alphaonex86/FPGA-ONU-1GPON-1GE/common/sniffer/sniffer-GPON-v2.jpg

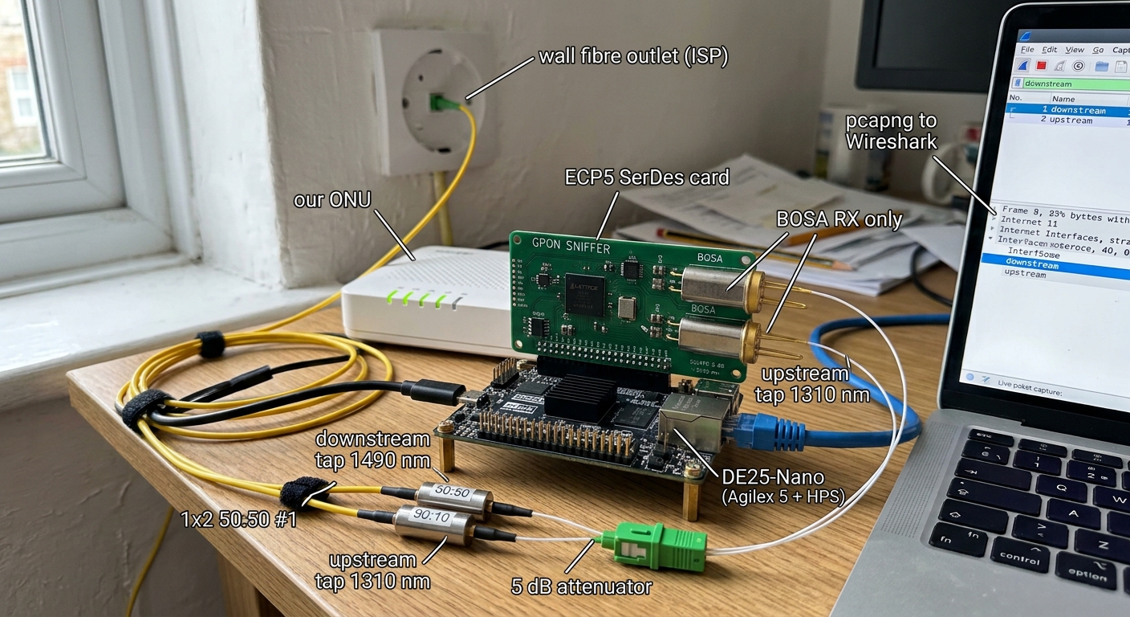
common/sniffer/sniffer-GPON-v2.jpg
