alphaonex86/FPGA-ONU-1GPON-1GE/common/sniffer/sniffer-GPON.jpg

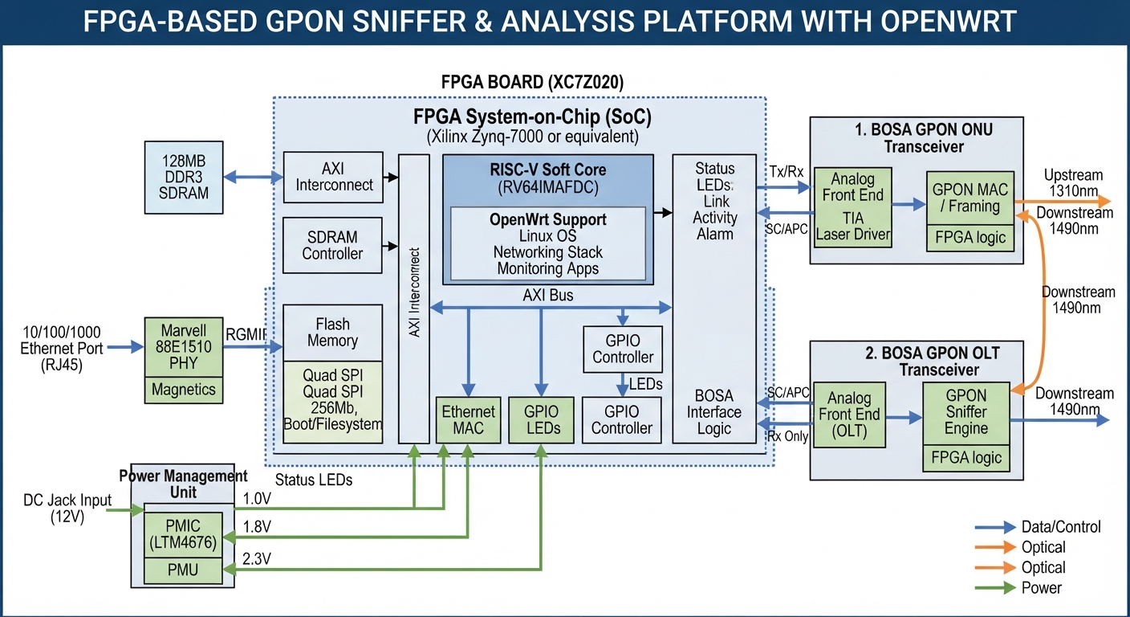
common/sniffer/sniffer-GPON.jpg
