alphaonex86/FPGA-ONU-1GPON-1GE/common/sniffer/sniffer-diagram.png

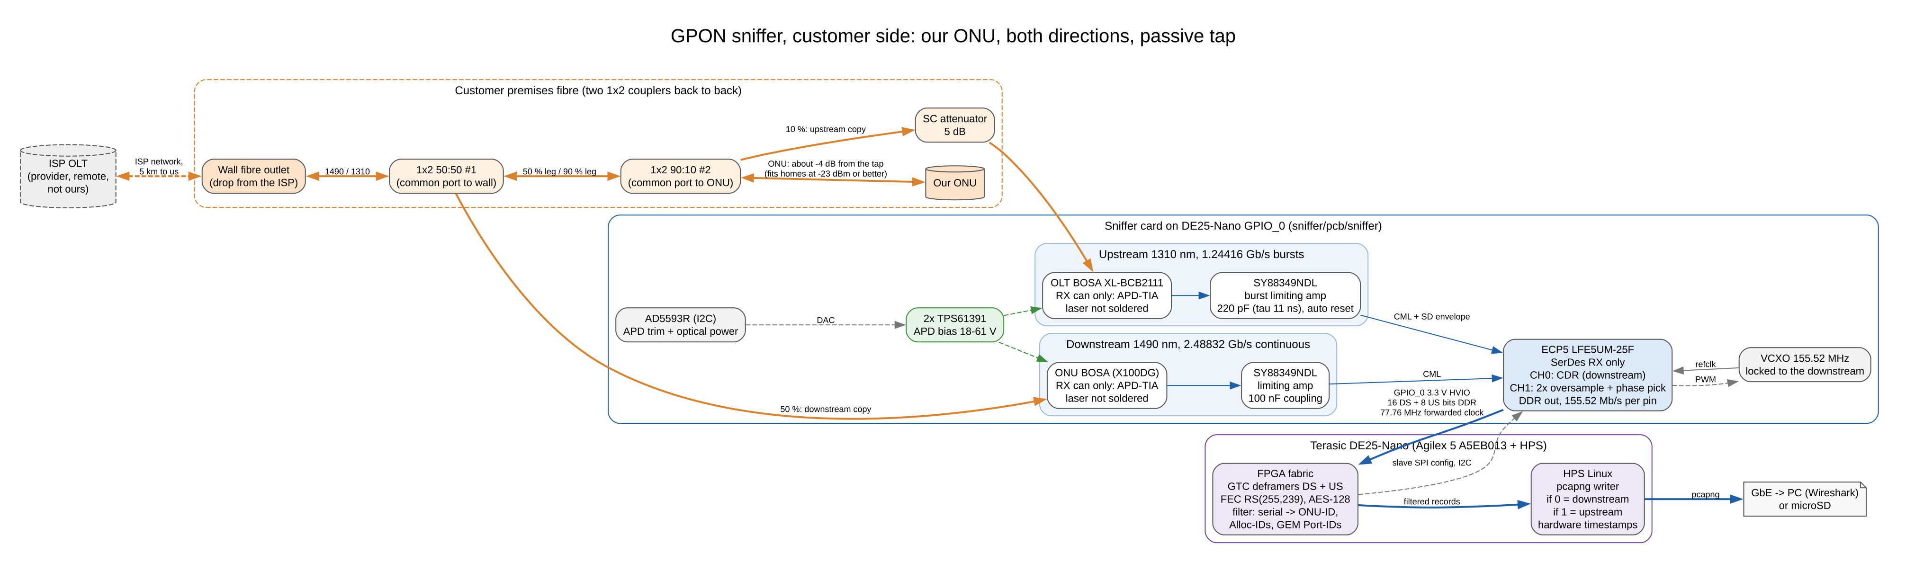
common/sniffer/sniffer-diagram.png
