alphaonex86/FPGA-ONU-1GPON-1GE/de25-standard/fpga-usage/README.md

# FPGA usage

Written by `agilex5/gts/usage_svg.py` at the end of every `fit.sh` PonBoard or ghrd fit: do not edit.

## ghrd

ghrd resources

ghrd blocks

ghrd onu

ghrd olt

## pon_board

pon_board resources

pon_board blocks

pon_board onu

pon_board olt
