alphaonex86/FPGA-ONU-1GPON-1GE/de25-standard/pcb/hsmc/sim/laser_driver.cir

* SPDX-License-Identifier: CERN-OHL-S-2.0
* BFR380F model: rough Gummel-Poon fit of the public datasheet (hFE 120, fT 14 GHz, Ccb 0.5 pF), not the vendor model
* Discrete burst-mode laser driver, 5 V laser rail, BFR380F current steering
.param ibias=30m imod=30m ui=803.75p
.model bfr NPN(IS=2e-15 BF=120 NF=1 VAF=30 IKF=0.15 RB=4 RE=0.4 RC=2 CJE=1.2p VJE=0.8 MJE=0.4 CJC=0.5p VJC=0.6 MJC=0.35 TF=9p TR=1n XTF=2 ITF=0.1)
.subckt q c b e
Lb b bi 0.4n
Le e ei 0.3n
Lc c ci 0.4n
Q1 ci bi ei bfr
.ends
.model las D(IS=1e-18 N=2 RS=4 CJO=2p)
V5 v5 0 5
V33 v33 0 3.3
* BOSA: laser anode on +5V_LD through the lead, cathode lead to the driver
Lla v5 la 2n
Dl la lk las
Llk lk ldk 2n
Rsn ldk sn 22
Csn sn v5 22p
* modulation pair, data AC-coupled from the GTS lane (+-200 mV per side), bases biased at 2.3 V through the 50 ohm terminations
Vd dp0 0 PWL(
+ 0.000000e+00 -1 4.822531e-09 -1 4.847531e-09 1 5.626286e-09 1 5.651286e-09 -1 9.645062e-09 -1
+ 9.670062e-09 1 1.125257e-08 1 1.127757e-08 -1 1.446759e-08 -1 1.449259e-08 1 1.527135e-08 1
+ 1.529635e-08 -1 1.607510e-08 -1 1.610010e-08 1 1.687886e-08 1 1.690386e-08 -1 1.929012e-08 -1
+ 1.931512e-08 1 2.250514e-08 1 2.253014e-08 -1 2.411265e-08 -1 2.413765e-08 1 2.491641e-08 1
+ 2.494141e-08 -1 2.732767e-08 -1 2.735267e-08 1 2.813143e-08 1 2.815643e-08 -1 2.893519e-08 -1
+ 2.896019e-08 1 3.054270e-08 1 3.056770e-08 -1 3.215021e-08 -1 3.217521e-08 1 3.456147e-08 1
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
print lon loff
meas tran vce_min_m1 min v(ldk)
meas tran vme max v(me)
meas tran vmt min v(mt)
meas tran vbt min v(bt)
meas tran ilmax max i(Lla) from=100n to=1.1u
meas tran ilmin min i(Lla) from=100n to=1.1u
wrdata laser.txt i(Lla) v(ben) v(bc) v(me) v(ldk) v(la) v(lk) v(mt) v(bt)
.endc
.end
