alphaonex86/FPGA-ONU-1GPON-1GE/de25-standard/pcb/hsmc/hsmc.kicad_pcb

## KiCad design de25-standard/pcb/hsmc/hsmc.kicad_pcb (2026-11-05)

Schematic: hsmc.kicad_sch, HSMC card for DE25-Standard: OLT/Ethernet and Ethernet SFP+…

Parts:
C1, C2, C7, C8, C11, C12, C15, C16, C18, C25, C27, C30, C32, C35, C36, C37, C38, C39, C40, C41, C42, C45, C46, C47, C48, C49, C51, C60, C61, C63, C65, C66: 100n; C_0402_1005Metric
C3, C4, C17, C26, C28, C31, C33, C43, C44, C50, C52: 10u; C_0603_1608Metric
C5, C6, C22, C23, C24, C29, C34: 22u; C_0805_2012Metric
C9, C10, C13, C14: 1u; C_0402_1005Metric
C19, C20: 10u; C_0805_2012Metric; MPN 10 uF 25 V X5R 0805
C21: 100n; C_0603_1608Metric; MPN 100 nF 25 V
C53, C54: 100n; C_0603_1608Metric; MPN 100 V X7R
C55: 220p; C_0603_1608Metric; MPN 100 V X7R
C56: 47n; C_0402_1005Metric
C57: 2.2u; C_0603_1608Metric
C58, C59: 10p; C_0402_1005Metric
C62: 100n; C_0603_1608Metric; MPN 100 nF 50 V X7R 0603
C64: 47p; C_0402_1005Metric
D1: BAT46WJ; D_SOD-323F; MPN BAT46WJ (100 V)
FB1, FB2, FB3, FB4: 120R@100MHz; L_0603_1608Metric; MPN BLM18PG121SN1D
H1, H2: M3; MountingHole_3.2mm_M3
J1: ASP-122952-01; HSMC_ASP-122952-01; MPN Samtec ASP-122952-01
J2: SFP0 cage; Connector_SFP_and_Cage; MPN SFP+ cage (SFF-8432) + 20-pin host conn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
J3: SFP1 cage; Connector_SFP_and_Cage; MPN SFP+ cage (SFF-8432) + 20-pin host conn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
L1: 2.2u; L_Cenker_CKCS4020; MPN 2.2 uH, Isat >= 4 A, 4020
L2, L3, L4, L5: 1u; L_0805_2012Metric; MPN 1 uH >= 1 A, low DCR
L6: 4.7u; L_Cenker_CKCS252012; MPN 4.7 uH, Isat >= 1 A, 2520
R1, R2, R5, R6: 150; R_0402_1005Metric
R3, R4, R7, R8, R10, R32, R34, R45, R51: 10k; R_0402_1005Metric
R9: 33.2k; R_0402_1005Metric
R11, R19: 33; R_0402_1005Metric
R12, R20: 330; R_0402_1005Metric
R13, R14, R15, R16, R17, R18, R21, R22, R23, R24, R25, R26, R27, R28, R52, R53, R57: 4.7k; R_0402_1005Metric
R29: 5.1k; R_0402_1005Metric
R30: 6.2k; R_0402_1005Metric
R31, R46: 20k; R_0402_1005Metric
R33: 12k; R_0402_1005Metric
R35: 5.6k; R_0402_1005Metric
R36: 3.9k; R_0402_1005Metric
R37, R49: 1.5k; R_0402_1005Metric
R38, R43, R56: 1k; R_0402_1005Metric
R39, R41, R48: 10; R_0402_1005Metric
R40: 15; R_0402_1005Metric
R42: 100; R_0402_1005Metric
R44: 300k; R_0603_1608Metric
R47: 33k; R_0402_1005Metric
R50: 3.01k; R_0402_1005Metric
R54: 0; R_0402_1005Metric; not fitted
R55: 15k; R_0402_1005Metric
R58, R59, R60, R61: 20; R_0402_1005Metric
U1: TPS563201DDCR; SOT-23-6; MPN TPS563201DDCR
U2: SY88236LMG; QFN-32-1EP_5x5mm_P0.5mm_EP3.1x3.1mm_ThermalVias; MPN SY88236LMG
U3: SN65LVDT2DBVR; SOT-23-5; MPN SN65LVDT2DBVR
U4: BOSA GPON (X100DG); BOSA_GPON; MPN desoldered from an X100DG; pad order to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
U5: TPS61391RTER; WQFN-16-1EP_3x3mm_P0.5mm_EP1.68x1.68mm_ThermalVias; MPN TPS61391RTER
U6: AD5593RBRUZ; TSSOP-16_4.4x5mm_P0.65mm; MPN AD5593RBRUZ
U7: SN74LVC1G123DCUR; VSSOP-8_2.3x2mm_P0.5mm; MPN SN74LVC1G123DCUR
U8: SN74LVC1G97DBVR; SOT-23-6; MPN SN74LVC1G97DBVR
U9: SN74LVC1G32DBVR; SOT-23-5; MPN SN74LVC1G32DBVR
Y1: SiT3821 156.25 MHz; Oscillator_SMD_SiTime_SiT9121-6Pin_3.2x2.5mm; MPN SiT3821AI-1B2-33NH156.250000
Y2: SiT3821 155.52 MHz; Oscillator_SMD_SiTime_SiT9121-6Pin_3.2x2.5mm; MPN SiT3821AI-1B2-33NE155.520000

Connections:
+3V3: C1.1, C2.1, C3.1, C4.1, C5.1, C6.1, C61.1, C63.1, C65.1, C66.1, FB1.1, FB2.1, FB4.1, J1.45 (3.3V), J1.51 (3.3V), J1.57 (3.3V), J1.63 (3.3V), J1.69 (3.3V), J1.75 (3.3V), J1.81 (3.3V), J1.87 (3.3V), J1.93 (3.3V), J1.99 (3.3V), J1.105 (3.3V), J1.111 (3.3V), J1.117 (3.3V), J1.123 (3.3V), J1.129 (3.3V), J1.135 (3.3V), J1.141 (3.3V), J1.147 (3.3V), J1.153 (3.3V), J1.159 (3.3V), R27.2, R28.2, R51.2, R52.2, R53.2, R55.2, R57.2, U6.3 (V_{DD}), U6.9 (V_{LOGIC}), U7.3 (~CLR), U7.8 (VCC), U8.5 (VCC), U9.5 (VCC)
+3V3_APD: C51.1, C52.1, FB4.2, L6.1, R48.1, U5.10 (VIN), U5.13 (EN)
+3V3_APDA: C57.1, R48.2, U5.14 (AVCC), U5.15 (AVCC)
+3V3_OPT: C39.1, C40.1, C41.1, C42.1, C43.1, C44.1, C45.1, FB2.2, FB3.1, R29.2, R40.2, U2.17 (VCC), U2.20 (VCC), U2.32 (VCC), U3.1 (VCC), U4.T1 (LD_A), U4.T4 (MPD_K)
+3V3_RX: C48.1, C49.1, C50.1, FB3.2, U4.R2 (VCC)
+3V3_SFP: C22.1, C23.1, C24.1, C29.1, C34.1, L1.2, L2.1, L3.1, L4.1, L5.1, R9.1, R13.2, R14.2, R15.2, R16.2, R17.2, R18.2, R21.2, R22.2, R23.2, R24.2, R25.2, R26.2
+3V3_SFP0R: C27.1, C28.1, J2.15 (VccR), L3.2
+3V3_SFP0T: C25.1, C26.1, J2.16 (VccT), L2.2
+3V3_SFP1R: C32.1, C33.1, J3.15 (VccR), L5.2
+3V3_SFP1T: C30.1, C31.1, J3.16 (VccT), L4.2
+3V3_XO: C15.1, C16.1, C17.1, FB1.2, Y1.6 (VDD), Y2.6 (VDD)
+12V: C19.1, C20.1, C21.1, J1.88 (12V), J1.94 (12V), J1.100 (12V), U1.3 (VIN), U1.5 (EN)
APCFAULT_N: U2.25 (~APCFAULT), U6.13 (IO7)
APCSET: R31.1, R32.1, U2.12 (APCSET)
APC_ADJ: R32.2, U6.4 (IO0)
APD_ADJ: R46.2, U6.6 (IO2)
APD_CAP: C56.1, U5.9 (CAP)
APD_FB: R44.2, R45.1, R46.1, U5.12 (FB)
APD_ISHORT: R47.1, U5.11 (ISHORT)
APD_MON: C58.1, R49.1, U5.4 (MON1), U6.11 (IO5)
APD_MON2: C59.1, R50.1, U5.3 (MON2)
BEN_DLY: C64.1, R56.2, U8.1 (IN1)
BEN_IO: J1.120 (LVDS_RXp11), R54.1
BIASMAX: R35.1, U2.14 (BIASMAX)
BIASMON: R37.1, U2.23 (BIASMON), U6.7 (IO3)
BST_SFP: C18.1, U1.6 (VBST)
BURST_CUT: J1.116 (LVDS_RXn10), U8.4 (Y), U9.2
CUT_C: C62.1, U7.6 (Cext)
CUT_Q: U7.5 (Q), U8.6 (IN2)
CUT_RC: C62.2, R55.1, U7.7 (RCext)
DDM_RESET: R51.1, U6.1 (~RESET)
DDM_VREF: C60.1, U6.8 (V_{REF})
FB_SFP: R9.2, R10.1, U1.4 (VFB)
GND: C1.2, C2.2, C3.2, C4.2, C5.2, C6.2, C9.2, C10.2, C13.2, C14.2, C15.2, C16.2, C17.2, C19.2, C20.2, C21.2, C22.2, C23.2, C24.2, C25.2, C26.2, C27.2, C28.2, C29.2, C30.2, C31.2, C32.2, C33.2, C34.2, C39.2, C40.2, C41.2, C42.2, C43.2, C44.2, C45.2, C48.2, C49.2, C50.2, C51.2, C52.2, C53.2, C54.2, C55.2, C56.2, C57.2, C58.2, C59.2, C60.2, C61.2, C63.2, C64.2, C65.2, C66.2, J1.160 (PSNTn), J1.161 (GND), J1.162 (GND), J1.163 (GND), J1.164 (GND), J1.165 (GND), J1.166 (GND), J1.167 (GND), J1.168 (GND), J1.169 (GND), J1.170 (GND), J1.171 (GND), J1.172 (GND), J2.1 (VeeT), J2.10 (VeeR), J2.11 (VeeR), J2.14 (VeeR), J2.17 (VeeT), J2.20 (VeeT), J2.CAGE, J3.1 (VeeT), J3.10 (VeeR), J3.11 (VeeR), J3.14 (VeeR), J3.17 (VeeT), J3.20 (VeeT), J3.CAGE, R1.2, R2.2, R5.2, R6.2, R10.2, R30.2, R31.2, R33.2, R35.2, R36.2, R37.2, R38.2, R45.2, R47.2, R49.2, R50.2, U1.1 (GND), U2.1 (LOS/SD_SEL), U2.5 (GND), U2.8 (GND), U2.16 (GND), U2.24 (GND), U2.29 (GND), U2.33 (EP), U3.2 (GND), U4.R5 (GND), U5.7 (GND), U5.16 (AGND), U5.17 (EP), U6.2 (A0), U6.14 (GND), U7.1 (~A), U7.4 (GND), U8.2 (GND), U8.3 (IN0), U9.3 (GND), Y1.3 (GND), Y2.3 (GND)
GTS_REFCLK_AC_N: C8.2, R59.1
GTS_REFCLK_AC_P: C7.2, R58.1
GTS_REFCLK_N: J1.8 (XCVR_RXn6), R59.2
GTS_REFCLK_P: J1.6 (XCVR_RXp6), R58.2
GTS_RXREF_AC_N: C12.2, R61.1
GTS_RXREF_AC_P: C11.2, R60.1
GTS_RXREF_N: J1.4 (XCVR_RXn7), R61.2
GTS_RXREF_P: J1.2 (XCVR_RXp7), R60.2
HV_APD: C55.1, U4.R1 (VAPD), U5.5 (APD)
HV_FILT: C54.1, R42.2, R43.1
HV_MONIN: R43.2, U5.6 (MONIN)
HV_OUT: C53.1, D1.1 (K), R42.1, R44.1
HV_SW: D1.2 (A), L6.2, U5.8 (SW)
LASER_DIS: R27.1, U2.11 (TXDIS), U9.4
LASER_DIS_FPGA: J1.102 (LVDS_RXp8), R57.1, U9.1
LD_BEN: R54.2, R56.1, U2.9 (BEN+), U3.5 (R), U7.2 (B)
LD_BEN_N: R30.1, U2.10 (BEN-)
LD_BIAS: R41.1, U2.21 (BIAS)
LD_K: R39.2, R41.2, U4.T2 (LD_K)
LD_MD: U2.22 (MD), U4.T3 (MPD_A)
LD_MODN: R40.1, U2.18 (MOD-)
LD_MODP: R39.1, U2.19 (MOD+)
LOSLVL: R29.1, U2.2 (LOSLVL)
MODMON: R36.1, U2.15 (MODMON), U6.10 (IO4)
MODSET: R33.1, R34.1, U2.13 (MODSET)
MOD_ADJ: R34.2, U6.5 (IO1)
ONU_BEN_N: J1.31 (XCVR_TXn0), U3.4 (B)
ONU_BEN_P: J1.29 (XCVR_TXp0), U3.3 (A)
ONU_RD_N: C38.1, U2.30 (ROUT-)
ONU_RD_P: C37.1, U2.31 (ROUT+)
ONU_RX_N: C38.2, J1.26 (XCVR_RXp1)
ONU_RX_P: C37.2, J1.28 (XCVR_RXn1)
ONU_SCL: J1.108 (LVDS_RXp9), R52.1, U6.16 (SCL)
ONU_SDA: J1.110 (LVDS_RXn9), R53.1, U6.15 (SDA)
ONU_TD_N: C36.2, U2.6 (DIN+)
ONU_TD_P: C35.2, U2.7 (DIN-)
ONU_TX_N: C36.1, J1.25 (XCVR_TXp1)
ONU_TX_P: C35.1, J1.27 (XCVR_TXn1)
RIN_N: C47.2, U2.28 (RIN-)
RIN_P: C46.2, U2.27 (RIN+)
RSSI: R38.1, U2.26 (RSSI), U6.12 (IO6)
RX_SD: J1.104 (LVDS_RXn8), R28.1, U2.3 (LOS/SD), U2.4 (~JAM)
SFP0_LOS: J1.48 (LVDS_RXp0), J2.8 (RX_LOS), R15.1
SFP0_MOD_ABS: J1.50 (LVDS_RXn0), J2.6 (MOD_ABS), R16.1
SFP0_P7: J2.7 (RS0), R11.2
SFP0_P9: J2.9 (RS1), R12.2
SFP0_RD_N: J1.18 (XCVR_RXp3), J2.12 (RD-)
SFP0_RD_P: J1.20 (XCVR_RXn3), J2.13 (RD+)
SFP0_RS0: J1.60 (LVDS_RXp2), R11.1
SFP0_RS1: J1.62 (LVDS_RXn2), R12.1
SFP0_SCL: J1.54 (LVDS_RXp1), J2.5 (SCL), R17.1
SFP0_SDA: J1.56 (LVDS_RXn1), J2.4 (SDA), R18.1
SFP0_TD_N: J1.19 (XCVR_TXn3), J2.19 (TD-)
SFP0_TD_P: J1.17 (XCVR_TXp3), J2.18 (TD+)
SFP0_TX_DIS: J1.42 (D1), J2.3 (TX_DISABLE), R14.1
SFP0_TX_FAULT: J1.44 (D3), J2.2 (TX_FAULT), R13.1
SFP1_LOS: J1.72 (LVDS_RXp4), J3.8 (RX_LOS), R23.1
SFP1_MOD_ABS: J1.74 (LVDS_RXn4), J3.6 (MOD_ABS), R24.1
SFP1_P7: J3.7 (RS0), R19.2
SFP1_P9: J3.9 (RS1), R20.2
SFP1_RD_N: J1.22 (XCVR_RXp2), J3.12 (RD-)
SFP1_RD_P: J1.24 (XCVR_RXn2), J3.13 (RD+)
SFP1_RS0: J1.84 (LVDS_RXp6), R19.1
SFP1_RS1: J1.86 (LVDS_RXn6), R20.1
SFP1_SCL: J1.78 (LVDS_RXp5), J3.5 (SCL), R25.1
SFP1_SDA: J1.80 (LVDS_RXn5), J3.4 (SDA), R26.1
SFP1_TD_N: J1.23 (XCVR_TXn2), J3.19 (TD-)
SFP1_TD_P: J1.21 (XCVR_TXp2), J3.18 (TD+)
SFP1_TX_DIS: J1.66 (LVDS_RXp3), J3.3 (TX_DISABLE), R22.1
SFP1_TX_FAULT: J1.68 (LVDS_RXn3), J3.2 (TX_FAULT), R21.1
SW_SFP: C18.2, L1.1, U1.2 (SW)
TIA_N: C47.1, U4.R4 (OUT-)
TIA_P: C46.1, U4.R3 (OUT+)
VCXO156_N: C8.1, R2.1, Y1.5 (OUT-)
VCXO156_P: C7.1, R1.1, Y1.4 (OUT+)
VCXO156_PWM: J1.122 (LVDS_RXn11), R3.1
VCXO156_RC: C9.1, R3.2, R4.1
VCXO156_VC: C10.1, R4.2, Y1.1 (VIN)
VCXO_N: C12.1, R6.1, Y2.5 (OUT-)
VCXO_P: C11.1, R5.1, Y2.4 (OUT+)
VCXO_PWM: J1.114 (LVDS_RXp10), R7.1
VCXO_RC: C13.1, R7.2, R8.1
VCXO_VC: C14.1, R8.2, Y2.1 (VIN)

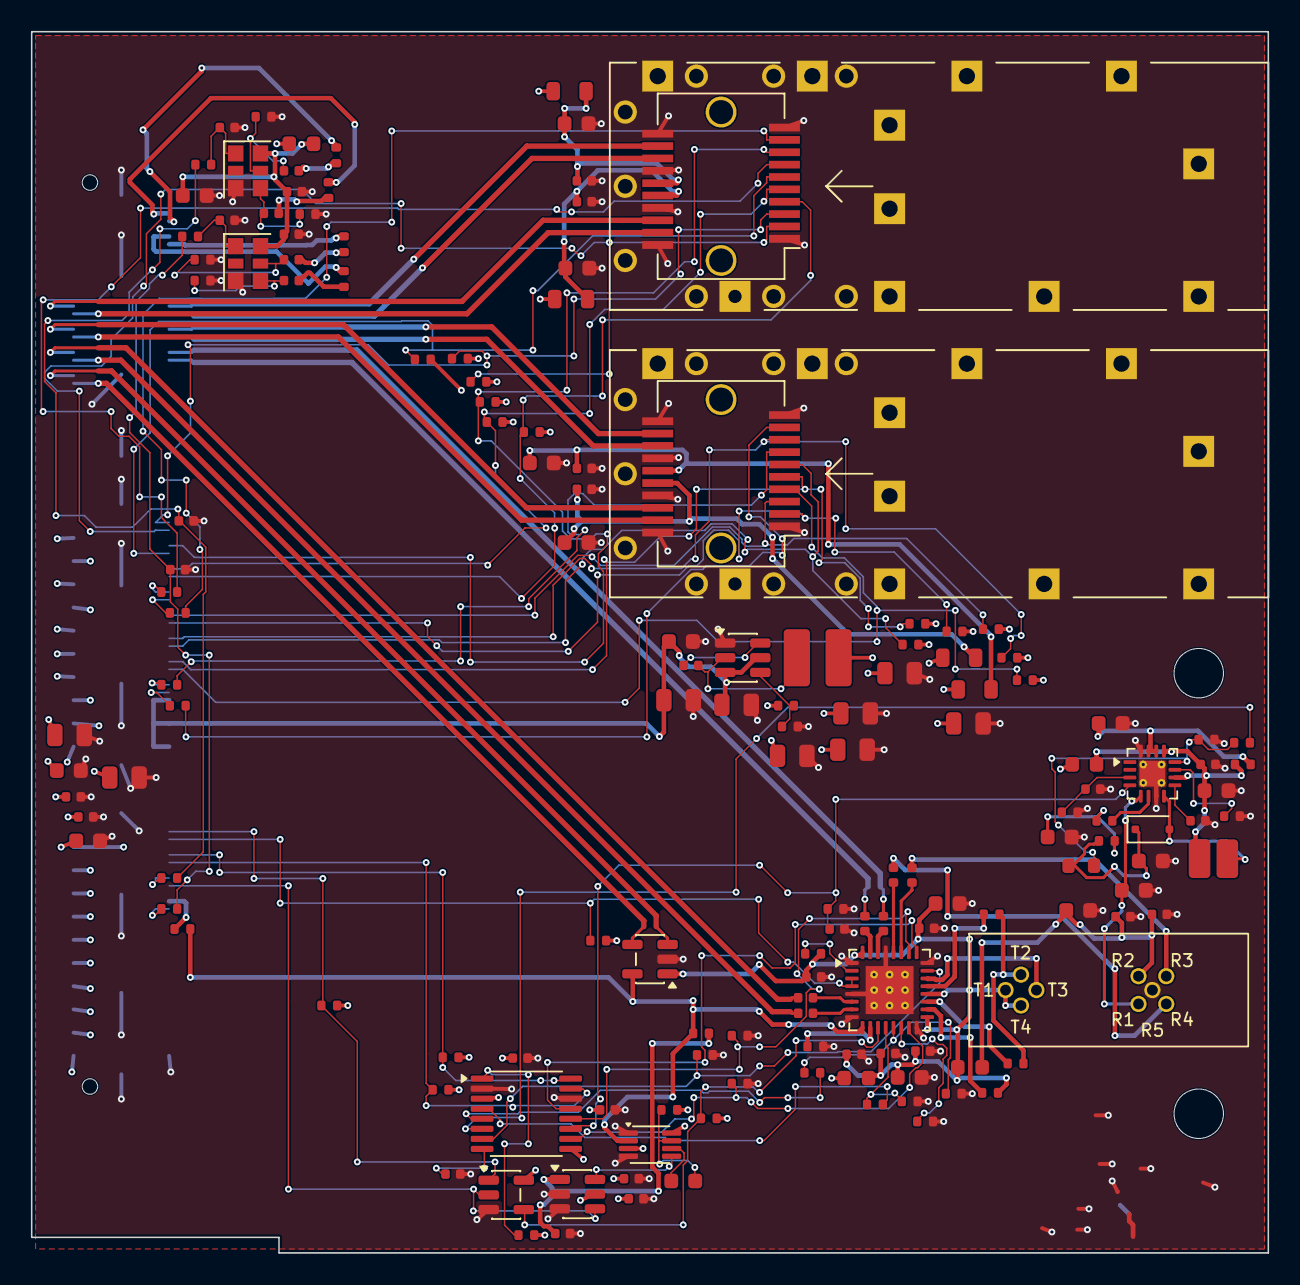
[picture p4: board hsmc.kicad_pcb from above]

Board: 4 copper layers, 80.0 x 79.0 mm, 154 parts (1 on the bottom side), 117 nets.
