alphaonex86/FPGA-ONU-1GPON-1GE/de25-nano/pcb/onu/onu.kicad_pcb

## KiCad design de25-nano/pcb/onu/onu.kicad_pcb (2026-11-05)

Schematic: onu.kicad_sch, ONU SerDes bridge for DE25-Nano

Parts:
C1, C3, C6, C9, C24, C25, C30, C48, C49, C50, C51, C54, C57, C60, C63, C65, C76, C77, C83, C85: 10u; C_0603_1608Metric
C2, C4, C5, C7, C8, C10, C11: 22u; C_0805_2012Metric
C12, C13, C66, C67: 1u; C_0402_1005Metric
C14, C15, C16, C17, C18, C19, C20, C21, C22, C23, C26, C27, C28, C29, C31, C32, C33, C34, C35, C36, C37, C38, C39, C40, C41, C42, C43, C44, C45, C46, C47, C52, C53, C55, C56, C58, C59, C61, C62, C64, C68, C69, C70, C71, C72, C73, C74, C75, C78, C79, C80, C81, C82, C84, C93, C94: 100n; C_0402_1005Metric
C86, C87: 100n; C_0603_1608Metric; MPN 100 V X7R
C88: 220p; C_0603_1608Metric; MPN 100 V X7R
C89: 47n; C_0402_1005Metric
C90: 2.2u; C_0603_1608Metric
C91, C92: 10p; C_0402_1005Metric
D1: BAT46WJ; D_SOD-323F; MPN BAT46WJ (100 V)
FB1, FB2, FB3, FB4, FB5, FB6, FB7, FB8, FB9: 120R@100MHz; L_0603_1608Metric; MPN BLM18PG121SN1D
H1, H2: M3; MountingHole_3.2mm_M3
J1: DE25-Nano GPIO; PinSocket_2x20_P2.54mm_Vertical
J2: JTAG; PinHeader_1x06_P2.54mm_Vertical
J3: OLT-ONU link; PinHeader_1x08_P2.54mm_Vertical
L1, L2: 2.2u; L_Cenker_CKCS252012; MPN CKCS252012-2R2M
L3: 4.7u; L_Cenker_CKCS252012; MPN 4.7 uH, Isat >= 1 A, 2520
R1, R3: 100k; R_0402_1005Metric
R2, R4: 120k; R_0402_1005Metric
R5, R6, R7, R8, R9, R12, R13, R14, R19, R20: 4.7k; R_0402_1005Metric
R10, R15, R16, R24, R26, R37, R43: 10k; R_0402_1005Metric
R11, R30, R35: 1k; R_0402_1005Metric
R17, R18: 0; R_0402_1005Metric
R21: 5.1k; R_0402_1005Metric
R22: 6.2k; R_0402_1005Metric
R23, R38: 20k; R_0402_1005Metric
R25: 12k; R_0402_1005Metric
R27: 5.6k; R_0402_1005Metric
R28: 3.9k; R_0402_1005Metric
R29, R41: 1.5k; R_0402_1005Metric
R31, R33, R40: 10; R_0402_1005Metric
R32: 15; R_0402_1005Metric
R34: 100; R_0402_1005Metric
R36: 300k; R_0603_1608Metric
R39: 33k; R_0402_1005Metric
R42: 3.01k; R_0402_1005Metric
RN1, RN2, RN3, RN4, RN5: 22; R_Array_Convex_4x0402; MPN 4D02WGJ0220TCE
U1, U2: TLV62569DBVR; SOT-23-5; MPN TLV62569DBVR
U3: TLV75525PDBVR; SOT-23-5; MPN TLV75525PDBVR
U4: LFE5UM-25F-6BG381C; Lattice_caBGA-381_17x17mm_Layout20x20_P0.8mm; MPN LFE5UM-25F-6BG381C
U5: SY88236LMG; QFN-32-1EP_5x5mm_P0.5mm_EP3.1x3.1mm_ThermalVias; MPN SY88236LMG
U6: SN65LVDT2DBVR; SOT-23-5; MPN SN65LVDT2DBVR
U7: BOSA GPON (X100DG); BOSA_GPON; MPN desoldered from an X100DG; pad order to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
U8: TPS61391RTER; WQFN-16-1EP_3x3mm_P0.5mm_EP1.68x1.68mm_ThermalVias; MPN TPS61391RTER
U9: AD5593RBRUZ; TSSOP-16_4.4x5mm_P0.65mm; MPN AD5593RBRUZ
Y1: SiT3821 155.52 MHz; Oscillator_SMD_SiTime_SiT9121-6Pin_3.2x2.5mm; MPN SiT3821AI-2B2-33NB155.520000 (LVDS, +-5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

Connections:
+1V1: C7.1, C8.1, C14.1, C15.1, C16.1, C17.1, C18.1, C19.1, C20.1, C21.1, C22.1, C23.1, C24.1, C25.1, L1.2, R1.1, U4.H8 (VCC), U4.H9 (VCC), U4.H10 (VCC), U4.H11 (VCC), U4.H12 (VCC), U4.H13 (VCC), U4.J8 (VCC), U4.J13 (VCC), U4.K8 (VCC), U4.K13 (VCC), U4.L8 (VCC), U4.L13 (VCC), U4.M8 (VCC), U4.M13 (VCC), U4.N8 (VCC), U4.N9 (VCC), U4.N10 (VCC), U4.N11 (VCC), U4.N12 (VCC), U4.N13 (VCC)
+1V1_HRX: C58.1, C59.1, C60.1, FB4.2, U4.T8 (VCCHRX0_D0CH0), U4.T9 (VCCHRX1_D0CH1)
+1V1_HTX: C55.1, C56.1, C57.1, FB3.2, U4.T7 (VCCHTX0_D0CH0), U4.T10 (VCCHTX1_D0CH1)
+1V1_SD: C10.1, C11.1, FB2.1, FB3.1, FB4.1, L2.2, R3.1
+1V1_VCCA: C52.1, C53.1, C54.1, FB2.2, U4.T6 (VCCA0), U4.U6 (VCCA0)
+2V5: C13.1, FB1.1, FB5.1, U3.5 (OUT)
+2V5_AUX: C26.1, C27.1, C28.1, C29.1, C30.1, FB1.2, U4.F6 (VCCAUX), U4.F15 (VCCAUX), U4.P6 (VCCAUX), U4.P15 (VCCAUX)
+2V5_AUXA: C61.1, C62.1, C63.1, FB5.2, U4.V10 (VCCAUXA0), U4.V11 (VCCAUXA0)
+3V3: C3.1, C4.1, C5.1, C12.1, C31.1, C32.1, C33.1, C34.1, C35.1, C36.1, C37.1, C38.1, C39.1, C40.1, C41.1, C42.1, C43.1, C44.1, C45.1, C46.1, C47.1, C48.1, C49.1, C50.1, C51.1, C94.1, FB6.1, FB7.1, FB9.1, J1.29, J2.1, R5.2, R6.2, R7.2, R8.2, R9.2, R10.2, R11.2, R12.2, R13.2, R19.2, R20.2, R43.2, U3.1 (IN), U3.3 (EN), U4.F9 (VCCIO0), U4.F10 (VCCIO0), U4.F11 (VCCIO1), U4.F12 (VCCIO1), U4.H6 (VCCIO7), U4.H7 (VCCIO7), U4.H14 (VCCIO2), U4.H15 (VCCIO2), U4.J6 (VCCIO7), U4.J15 (VCCIO2), U4.L6 (VCCIO6), U4.L7 (VCCIO6), U4.L14 (VCCIO3), U4.L15 (VCCIO3), U4.M6 (VCCIO6), U4.M15 (VCCIO3), U4.P9 (VCCIO8), U4.P10 (VCCIO8), U9.3 (V_{DD}), U9.9 (V_{LOGIC})
+3V3_APD: C84.1, C85.1, FB9.2, L3.1, R40.1, U8.10 (VIN), U8.13 (EN)
+3V3_APDA: C90.1, R40.2, U8.14 (AVCC), U8.15 (AVCC)
+3V3_OPT: C72.1, C73.1, C74.1, C75.1, C76.1, C77.1, C78.1, FB7.2, FB8.1, R21.2, R32.2, U5.17 (VCC), U5.20 (VCC), U5.32 (VCC), U6.1 (VCC), U7.T1 (LD_A), U7.T4 (MPD_K)
+3V3_RX: C81.1, C82.1, C83.1, FB8.2, U7.R2 (VCC)
+3V3_XO: C64.1, C65.1, FB6.2, Y1.6 (VDD)
+5V: C1.1, C2.1, C6.1, C9.1, J1.11, U1.1 (EN), U1.4 (VIN), U2.1 (EN), U2.4 (VIN)
APCFAULT_N: U5.25 (~APCFAULT), U9.13 (IO7)
APCSET: R23.1, R24.1, U5.12 (APCSET)
APC_ADJ: R24.2, U9.4 (IO0)
APD_ADJ: R38.2, U9.6 (IO2)
APD_CAP: C89.1, U8.9 (CAP)
APD_FB: R36.2, R37.1, R38.1, U8.12 (FB)
APD_ISHORT: R39.1, U8.11 (ISHORT)
APD_MON: C91.1, R41.1, U8.4 (MON1), U9.11 (IO5)
APD_MON2: C92.1, R42.1, U8.3 (MON2)
BEN0: J1.15, U4.A13 (PT40B)
BEN1: J1.17, U4.A12 (PT40A)
BEN2: J1.19, U4.A11 (PT27B/PCLKC0_1)
BEN3: J1.20, U4.B10 (PT24B/GR_PCLK0_0)
BEN4: J1.21, U4.A8 (PT18B)
BEN5: J1.22, U4.B9 (PT22A)
BEN6: J1.24, U4.B8 (PT15B)
BEN7: J1.26, U4.A7 (PT18A)
BEN_N: R18.1, U4.W9 (HDTXN0_D0CH1)
BEN_P: R17.1, U4.W8 (HDTXP0_D0CH1)
BIASMAX: R27.1, U5.14 (BIASMAX)
BIASMON: R29.1, U5.23 (BIASMON), U9.7 (IO3)
CCLK: J3.4, R11.1, U4.U3 (CCLK)
CFG0: R5.1, U4.U4 (CFG_0)
DDM_RESET: R43.1, U9.1 (~RESET)
DDM_VREF: C93.1, U9.8 (V_{REF})
DONE: R8.1, U4.Y3 (DONE)
DS0: J1.13, RN4.5 (R4.2)
DS0_S: RN4.4 (R4.1), U4.A14 (PT47A)
DS1: J1.14, RN4.6 (R3.2)
DS1_S: RN4.3 (R3.1), U4.B13 (PT42A)
DS2: J1.16, RN4.7 (R2.2)
DS2_S: RN4.2 (R2.1), U4.B12 (PT35A/PCLKT1_0)
DS3: J1.18, RN4.8 (R1.2)
DS3_S: RN4.1 (R1.1), U4.B11 (PT29A/PCLKT0_0)
DS4: J1.23, RN3.5 (R4.2)
DS4_S: RN3.4 (R4.1), U4.A9 (PT24A/GR_PCLK0_1)
DS5: J1.27, RN3.6 (R3.2)
DS5_S: RN3.3 (R3.1), U4.B6 (PT4B)
DS6: J1.28, RN3.7 (R2.2)
DS6_S: RN3.2 (R2.1), U4.A6 (PT4A)
DS7: J1.31, RN3.8 (R1.2)
DS7_S: RN3.1 (R1.1), U4.B5 (PL2C)
DS8: J1.32, RN2.5 (R4.2)
DS8_S: RN2.4 (R4.1), U4.A5 (PL2B)
DS9: J1.33, RN2.6 (R3.2)
DS9_S: RN2.3 (R3.1), U4.B4 (PL5B)
DS10: J1.34, RN2.7 (R2.2)
DS10_S: RN2.2 (R2.1), U4.A4 (PL2A)
DS11: J1.35, RN2.8 (R1.2)
DS11_S: RN2.1 (R1.1), U4.B3 (PL5D)
DS12: J1.36, RN1.5 (R4.2)
DS12_S: RN1.4 (R4.1), U4.A3 (PL5C)
DS13: J1.37, RN1.6 (R3.2)
DS13_S: RN1.3 (R3.1), U4.B2 (PL14C/VREF1_7)
DS14: J1.38, RN1.7 (R2.2)
DS14_S: RN1.2 (R2.1), U4.A2 (PL14A)
DS15: J1.39, RN1.8 (R1.2)
DS15_S: RN1.1 (R1.1), U4.B1 (PL14B)
DS_CLK: J1.1, RN5.7 (R2.2)
DS_CLK_S: RN5.2 (R2.1), U4.B20 (PT67B)
FB_1V1: R1.2, R2.1, U1.5 (FB)
FB_1V1_SD: R3.2, R4.1, U2.5 (FB)
GND: C1.2, C2.2, C3.2, C4.2, C5.2, C6.2, C7.2, C8.2, C9.2, C10.2, C11.2, C12.2, C13.2, C14.2, C15.2, C16.2, C17.2, C18.2, C19.2, C20.2, C21.2, C22.2, C23.2, C24.2, C25.2, C26.2, C27.2, C28.2, C29.2, C30.2, C31.2, C32.2, C33.2, C34.2, C35.2, C36.2, C37.2, C38.2, C39.2, C40.2, C41.2, C42.2, C43.2, C44.2, C45.2, C46.2, C47.2, C48.2, C49.2, C50.2, C51.2, C52.2, C53.2, C54.2, C55.2, C56.2, C57.2, C58.2, C59.2, C60.2, C61.2, C62.2, C63.2, C64.2, C65.2, C66.2, C67.2, C72.2, C73.2, C74.2, C75.2, C76.2, C77.2, C78.2, C81.2, C82.2, C83.2, C84.2, C85.2, C86.2, C87.2, C88.2, C89.2, C90.2, C91.2, C92.2, C93.2, C94.2, J1.12, J1.30, J2.6, J3.1, J3.8, R2.2, R4.2, R14.2, R22.2, R23.2, R25.2, R27.2, R28.2, R29.2, R30.2, R37.2, R39.2, R41.2, R42.2, U1.2 (GND), U2.2 (GND), U3.2 (GND), U4.B7 (GND), U4.B14 (GND), U4.C19 (GND), U4.D4 (GND), U4.F7 (GND), U4.F8 (GND), U4.F13 (GND), U4.F14 (GND), U4.G4 (GND), U4.G6 (GND), U4.G7 (GND), U4.G8 (GND), U4.G9 (GND), U4.G10 (GND), U4.G11 (GND), U4.G12 (GND), U4.G13 (GND), U4.G14 (GND), U4.G15 (GND), U4.G17 (GND), U4.H19 (GND), U4.J2 (GND), U4.J7 (GND), U4.J9 (GND), U4.J10 (GND), U4.J11 (GND), U4.J12 (GND), U4.J14 (GND), U4.K6 (GND), U4.K7 (GND), U4.K9 (GND), U4.K10 (GND), U4.K11 (GND), U4.K12 (GND), U4.K14 (GND), U4.K15 (GND), U4.L9 (GND), U4.L10 (GND), U4.L11 (GND), U4.L12 (GND), U4.M2 (GND), U4.M7 (GND), U4.M9 (GND), U4.M10 (GND), U4.M11 (GND), U4.M12 (GND), U4.M14 (GND), U4.M16 (GND), U4.N6 (GND), U4.N7 (GND), U4.N14 (GND), U4.N15 (GND), U4.P7 (GND), U4.P8 (GND), U4.P11 (GND), U4.P12 (GND), U4.P13 (GND), U4.P14 (GND), U4.R4 (CFG_2), U4.R19 (GND), U4.T4 (CFG_1), U4.U7 (GND), U4.U8 (GND), U4.U9 (GND), U4.U10 (GND), U4.U11 (GND), U4.U12 (GND), U4.U13 (GND), U4.U14 (GND), U4.V5 (GND), U4.V6 (GND), U4.V7 (GND), U4.V8 (GND), U4.V9 (GND), U4.V12 (GND), U4.V13 (GND), U4.V14 (GND), U4.V15 (GND), U4.V16 (GND), U4.V19 (GND), U4.V20 (GND), U4.W6 (GND), U4.W7 (GND), U4.W12 (GND), U4.W15 (GND), U4.W16 (GND), U4.W19 (GND), U4.Y7 (HDRXP0_D0CH1), U4.Y8 (HDRXN0_D0CH1), U5.1 (LOS/SD_SEL), U5.5 (GND), U5.8 (GND), U5.16 (GND), U5.24 (GND), U5.29 (GND), U5.33 (EP), U6.2 (GND), U7.R5 (GND), U8.7 (GND), U8.16 (AGND), U8.17 (EP), U9.2 (A0), U9.14 (GND), Y1.3 (GND)
HOLDN: R10.1, U4.R2 (PB15A/HOLDN/DI/BUSY/CSSPIN/CEN)
HV_APD: C88.1, U7.R1 (VAPD), U8.5 (APD)
HV_FILT: C87.1, R34.2, R35.1
HV_MONIN: R35.2, U8.6 (MONIN)
HV_OUT: C86.1, D1.1 (K), R34.1, R36.1
HV_SW: D1.2 (A), L3.2, U8.8 (SW)
INITN: R7.1, U4.V3 (INITN)
LASER_DIS: R19.1, U4.U17 (PR47B), U5.11 (TXDIS)
LD_BEN: U5.9 (BEN+), U6.5 (R)
LD_BEN_N: R22.1, U5.10 (BEN-)
LD_BIAS: R33.1, U5.21 (BIAS)
LD_K: R31.2, R33.2, U7.T2 (LD_K)
LD_MD: U5.22 (MD), U7.T3 (MPD_A)
LD_MODN: R32.1, U5.18 (MOD-)
LD_MODP: R31.1, U5.19 (MOD+)
LOSLVL: R21.1, U5.2 (LOSLVL)
MISO: J3.6, U4.V2 (PB11A/D1/MISO/IO1)
MODMON: R28.1, U5.15 (MODMON), U9.10 (IO4)
MODSET: R25.1, R26.1, U5.13 (MODSET)
MOD_ADJ: R26.2, U9.5 (IO1)
MOSI: J3.5, U4.W2 (PB11B/D0/MOSI/IO0)
ONU_BEN_N: R18.2, U6.4 (B)
ONU_BEN_P: R17.2, U6.3 (A)
ONU_PROGRAMN: J3.7, R6.1, U4.W3 (PROGRAMN)
ONU_RD_N: C71.1, U5.30 (ROUT-)
ONU_RD_P: C70.1, U5.31 (ROUT+)
ONU_SCL: J3.2, U9.16 (SCL)
ONU_SDA: J3.3, U9.15 (SDA)
ONU_TD_N: C69.2, U5.6 (DIN+)
ONU_TD_P: C68.2, U5.7 (DIN-)
REFCLK_N: U4.Y12 (REFCLKN_D0), Y1.5 (OUT-)
REFCLK_P: U4.Y11 (REFCLKP_D0), Y1.4 (OUT+)
RIN_N: C80.2, U5.28 (RIN-)
RIN_P: C79.2, U5.27 (RIN+)
RSSI: R30.1, U5.26 (RSSI), U9.12 (IO6)
RX0_N: C71.2, U4.Y6 (HDRXN0_D0CH0)
RX0_P: C70.2, U4.Y5 (HDRXP0_D0CH0)
RX_SD: R20.1, U4.T17 (PR47D/LRC_GPLL0C_IN), U5.3 (LOS/SD), U5.4 (~JAM)
SN: J1.40, R9.1, U4.T2 (PB13A/SN/CSN)
SW_1V1: L1.1, U1.3 (SW)
SW_1V1_SD: L2.1, U2.3 (SW)
TCK: J2.2, R14.1, U4.T5 (TCK)
TDI: J2.3, R12.1, U4.R5 (TDI)
TDO: J2.4, U4.V4 (TDO)
TIA_N: C80.1, U7.R4 (OUT-)
TIA_P: C79.1, U7.R3 (OUT+)
TMS: J2.5, R13.1, U4.U5 (TMS)
TX0_N: C69.1, U4.W5 (HDTXN0_D0CH0)
TX0_P: C68.1, U4.W4 (HDTXP0_D0CH0)
TX_CLK: J1.3, RN5.8 (R1.2)
TX_CLK_S: RN5.1 (R1.1), U4.A19 (PT67A)
US0: J1.2, U4.B19 (PT65B)
US1: J1.4, U4.B18 (PT62B)
US2: J1.5, U4.A18 (PT65A)
US3: J1.6, U4.B17 (PT60A)
US4: J1.7, U4.A17 (PT62A)
US5: J1.8, U4.B16 (PT56B)
US6: J1.9, U4.A16 (PT56A)
US7: J1.10, U4.B15 (PT51A)
US_CLK: J1.25, U4.A10 (PT27A/PCLKT0_1)
VCXO_PWM: R15.1, U4.U16 (PR47C/LRC_GPLL0T_IN)
VCXO_RC: C66.1, R15.2, R16.1
VCXO_VC: C67.1, R16.2, Y1.1 (VIN)
