alphaonex86/FPGA-ONU-1GPON-1GE/de25-nano/pcb/onu/onu.kicad_pcb

## KiCad design de25-nano/pcb/onu/onu.kicad_pcb (continued)

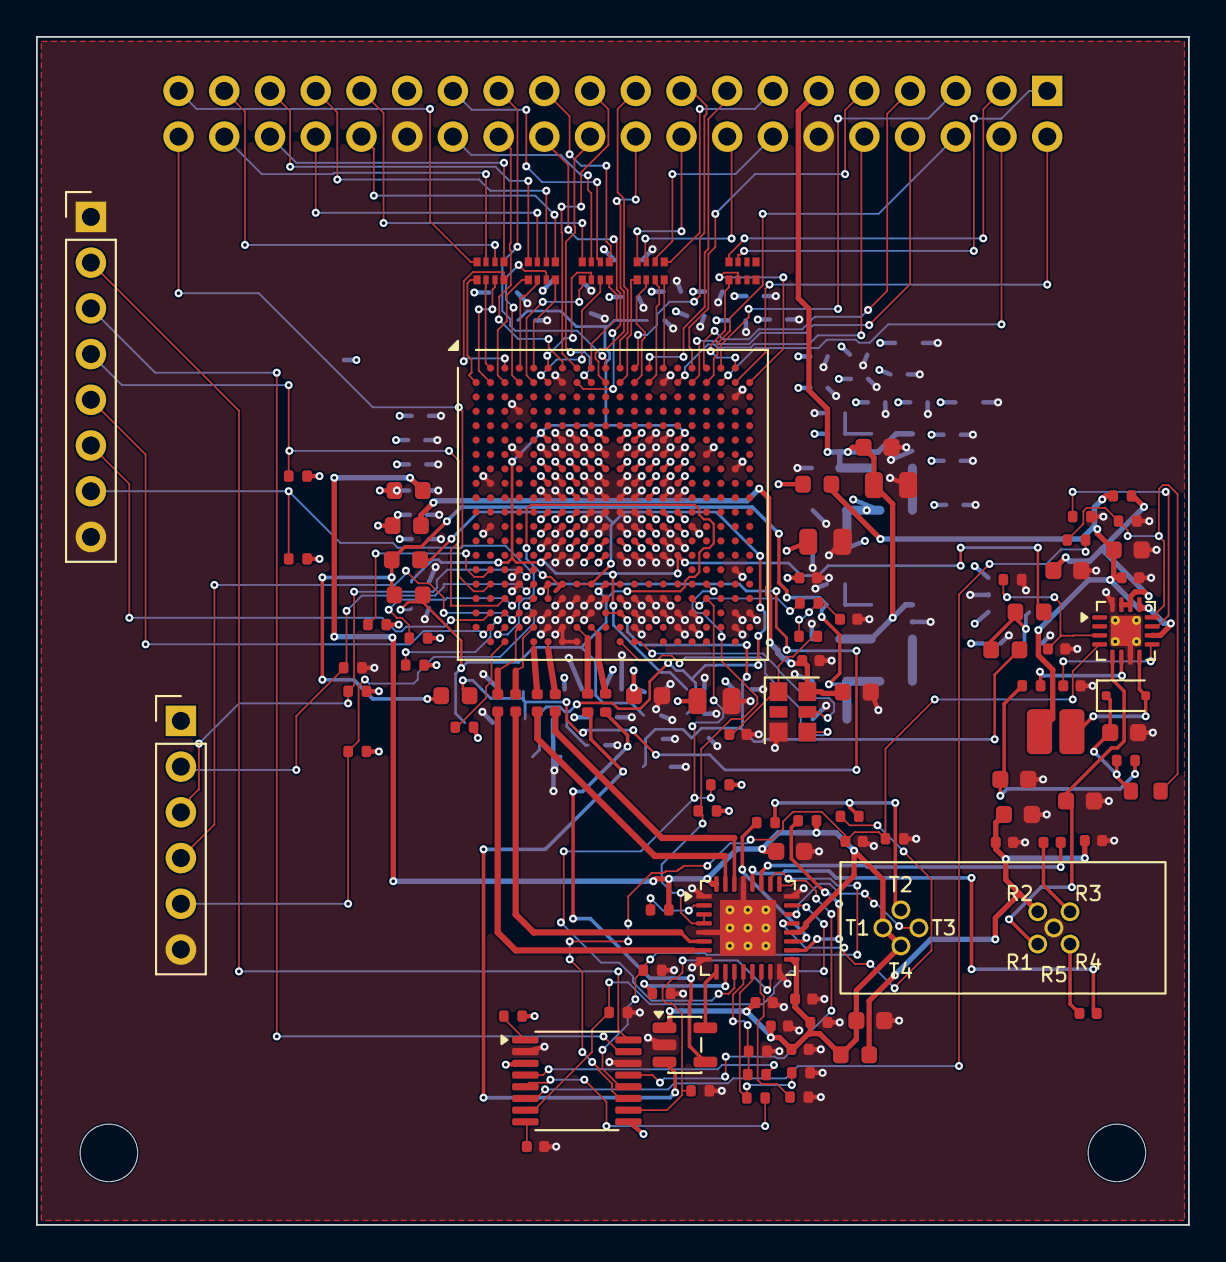
[picture p7: board onu.kicad_pcb from above]

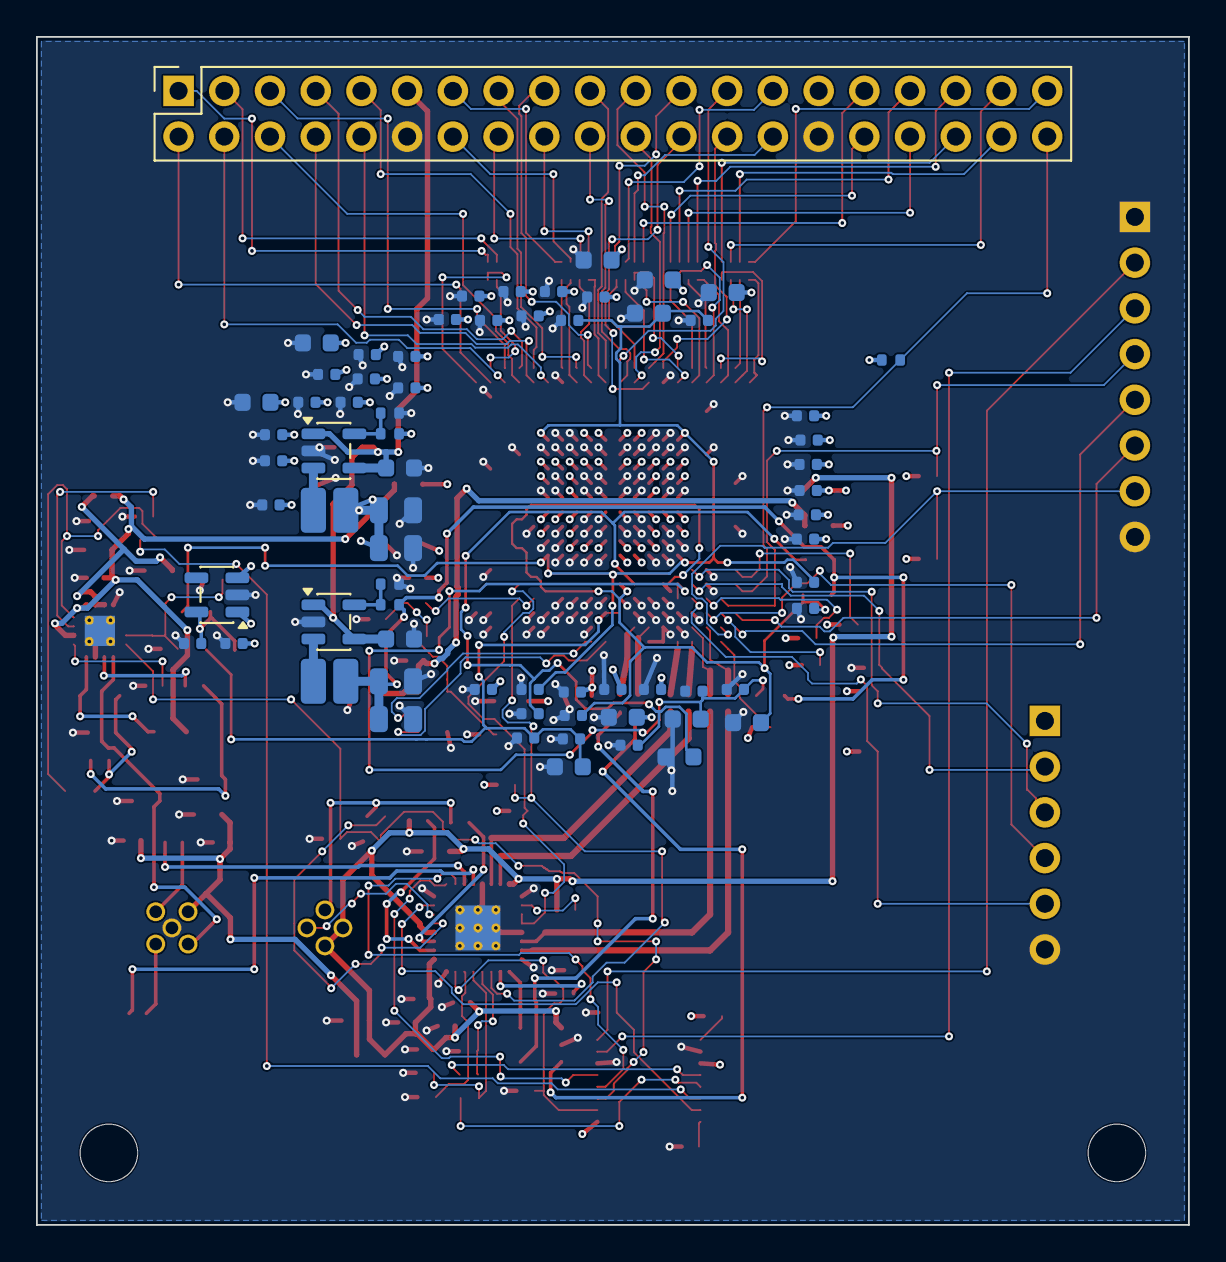
[picture p8: board onu.kicad_pcb from below]

Board: 4 copper layers, 64.0 x 66.0 mm, 170 parts (69 on the bottom side), 141 nets.
