alphaonex86/FPGA-ONU-1GPON-1GE/de25-nano/pcb/olt/olt.kicad_pcb

## KiCad design de25-nano/pcb/olt/olt.kicad_pcb (2026-11-01)

Schematic: olt.kicad_sch, OLT SerDes bridge for DE25-Nano

Parts:
C1, C3, C6, C9, C24, C25, C30, C48, C49, C50, C51, C54, C57, C60, C63, C66, C72, C74: 10u; C_0603_1608Metric
C2, C4, C5, C7, C8, C10, C11, C75: 22u; C_0805_2012Metric
C12, C13: 1u; C_0402_1005Metric
C14, C15, C16, C17, C18, C19, C20, C21, C22, C23, C26, C27, C28, C29, C31, C32, C33, C34, C35, C36, C37, C38, C39, C40, C41, C42, C43, C44, C45, C46, C47, C52, C53, C55, C56, C58, C59, C61, C62, C64, C65, C67, C68, C69, C70, C71, C73: 100n; C_0402_1005Metric
FB1, FB2, FB3, FB4, FB5, FB6: 120R@100MHz; L_0603_1608Metric; MPN BLM18PG121SN1D
H1, H2: M3; MountingHole_3.2mm_M3
J1: DE25-Nano GPIO; PinSocket_2x20_P2.54mm_Vertical
J2: JTAG; PinHeader_1x06_P2.54mm_Vertical
J3: SFP cage; Connector_SFP_and_Cage; MPN TE 1367073-1 + cage 2227302-1
J4: OLT-ONU link; PinHeader_1x08_P2.54mm_Vertical
L1, L2: 2.2u; L_Cenker_CKCS252012; MPN CKCS252012-2R2M
L3, L4: 1u; L_0805_2012Metric; MPN 1 uH >= 1 A, low DCR
R1, R3: 100k; R_0402_1005Metric
R2, R4: 120k; R_0402_1005Metric
R5, R6, R7, R8, R9, R12, R13, R14, R21, R22, R27, R28, R29, R30, R31, R32: 4.7k; R_0402_1005Metric
R10, R15, R16, R17, R20, R23, R24: 10k; R_0402_1005Metric
R11: 1k; R_0402_1005Metric
R18, R19: 2.2k; R_0402_1005Metric
R25: 33; R_0402_1005Metric
R26: 330; R_0402_1005Metric
RN1, RN2, RN3: 22; R_Array_Convex_4x0402; MPN 4D02WGJ0220TCE
U1, U2: TLV62569DBVR; SOT-23-5; MPN TLV62569DBVR
U3: TLV75525PDBVR; SOT-23-5; MPN TLV75525PDBVR
U4: LFE5UM-25F-6BG381C; Lattice_caBGA-381_17x17mm_Layout20x20_P0.8mm; MPN LFE5UM-25F-6BG381C
U5: PCA9555PW; TSSOP-24_4.4x7.8mm_P0.65mm; MPN PCA9555PW
U6: PCA9540BD; SOIC-8_3.9x4.9mm_P1.27mm; MPN PCA9540BD
U7, U8: SN74LVC1G125DBVR; SOT-23-5; MPN SN74LVC1G125DBVR
Y1: SiT9121 155.52 MHz; Oscillator_SMD_SiTime_SiT9121-6Pin_3.2x2.5mm; MPN SiT9121AI-2B3-33E155.52000 (LVDS; check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
Y2: SiT9121 125 MHz; Oscillator_SMD_SiTime_SiT9121-6Pin_3.2x2.5mm; MPN SiT9121AI-2B3-33E125000 (LVDS; check co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

Connections:
+1V1: C7.1, C8.1, C14.1, C15.1, C16.1, C17.1, C18.1, C19.1, C20.1, C21.1, C22.1, C23.1, C24.1, C25.1, L1.2, R1.1, U4.H8 (VCC), U4.H9 (VCC), U4.H10 (VCC), U4.H11 (VCC), U4.H12 (VCC), U4.H13 (VCC), U4.J8 (VCC), U4.J13 (VCC), U4.K8 (VCC), U4.K13 (VCC), U4.L8 (VCC), U4.L13 (VCC), U4.M8 (VCC), U4.M13 (VCC), U4.N8 (VCC), U4.N9 (VCC), U4.N10 (VCC), U4.N11 (VCC), U4.N12 (VCC), U4.N13 (VCC)
+1V1_HRX: C58.1, C59.1, C60.1, FB4.2, U4.T8 (VCCHRX0_D0CH0)
+1V1_HTX: C55.1, C56.1, C57.1, FB3.2, U4.T7 (VCCHTX0_D0CH0), U4.T10 (VCCHTX1_D0CH1)
+1V1_SD: C10.1, C11.1, FB2.1, FB3.1, FB4.1, L2.2, R3.1
+1V1_VCCA: C52.1, C53.1, C54.1, FB2.2, U4.T6 (VCCA0), U4.U6 (VCCA0)
+2V5: C13.1, FB1.1, FB5.1, U3.5 (OUT)
+2V5_AUX: C26.1, C27.1, C28.1, C29.1, C30.1, FB1.2, U4.F6 (VCCAUX), U4.F15 (VCCAUX), U4.P6 (VCCAUX), U4.P15 (VCCAUX)
+2V5_AUXA: C61.1, C62.1, C63.1, FB5.2, U4.V10 (VCCAUXA0), U4.V11 (VCCAUXA0)
+3V3: C3.1, C4.1, C5.1, C12.1, C31.1, C32.1, C33.1, C34.1, C35.1, C36.1, C37.1, C38.1, C39.1, C40.1, C41.1, C42.1, C43.1, C44.1, C45.1, C46.1, C47.1, C48.1, C49.1, C50.1, C51.1, C67.1, C68.1, C69.1, C70.1, C75.1, FB6.1, J1.29, J2.1, L3.1, L4.1, R5.2, R6.2, R7.2, R8.2, R9.2, R10.2, R11.2, R12.2, R13.2, R15.2, R16.2, R18.2, R19.2, R20.2, R21.2, R22.2, R23.2, R24.2, R27.2, R28.2, R29.2, R30.2, R31.2, R32.2, U3.1 (IN), U3.3 (EN), U4.F9 (VCCIO0), U4.F10 (VCCIO0), U4.F11 (VCCIO1), U4.F12 (VCCIO1), U4.H6 (VCCIO7), U4.H7 (VCCIO7), U4.H14 (VCCIO2), U4.H15 (VCCIO2), U4.J6 (VCCIO7), U4.J15 (VCCIO2), U4.L6 (VCCIO6), U4.L7 (VCCIO6), U4.L14 (VCCIO3), U4.L15 (VCCIO3), U4.M6 (VCCIO6), U4.M15 (VCCIO3), U4.P9 (VCCIO8), U4.P10 (VCCIO8), U5.24 (VDD), U6.3 (VDD), U7.5 (VCC), U8.5 (VCC)
+3V3_SFPR: C73.1, C74.1, J3.15 (VccR), L4.2
+3V3_SFPT: C71.1, C72.1, J3.16 (VccT), L3.2
+3V3_XO: C64.1, C65.1, C66.1, FB6.2, Y1.6 (VDD), Y2.6 (VDD)
+5V: C1.1, C2.1, C6.1, C9.1, J1.11, U1.1 (EN), U1.4 (VIN), U2.1 (EN), U2.4 (VIN)
AUX: J1.16, RN1.8 (R1.2)
AUX_S: RN1.1 (R1.1), U4.A10 (PT27A/PCLKT0_1)
CCLK: J1.37, J4.4, R11.1, U4.U3 (CCLK)
CFG0: R5.1, U4.U4 (CFG_0)
DONE: R8.1, U4.Y3 (DONE)
DS0: J1.3, U4.B18 (PT62B)
DS1: J1.13, U4.A12 (PT40A)
DS2: J1.14, U4.B11 (PT29A/PCLKT0_0)
DS3: J1.15, U4.A11 (PT27B/PCLKC0_1)
DS4: J1.23, U4.A9 (PT24A/GR_PCLK0_1)
DS5: J1.24, U4.A8 (PT18B)
DS6: J1.25, U4.A7 (PT18A)
DS7: J1.26, U4.B6 (PT4B)
DS8: J1.27, U4.A6 (PT4A)
DS9: J1.28, U4.A5 (PL2B)
DS10: J1.31, U4.B4 (PL5B)
DS11: J1.32, U4.A4 (PL2A)
DS12: J1.33, U4.A3 (PL5C)
DS13: J1.34, U4.B2 (PL14C/VREF1_7)
DS14: J1.35, U4.A2 (PL14A)
DS15: J1.36, U4.B1 (PL14B)
DS_CLK: J1.22, U4.B12 (PT35A/PCLKT1_0)
FB_1V1: R1.2, R2.1, U1.5 (FB)
FB_1V1_SD: R3.2, R4.1, U2.5 (FB)
GND: C1.2, C2.2, C3.2, C4.2, C5.2, C6.2, C7.2, C8.2, C9.2, C10.2, C11.2, C12.2, C13.2, C14.2, C15.2, C16.2, C17.2, C18.2, C19.2, C20.2, C21.2, C22.2, C23.2, C24.2, C25.2, C26.2, C27.2, C28.2, C29.2, C30.2, C31.2, C32.2, C33.2, C34.2, C35.2, C36.2, C37.2, C38.2, C39.2, C40.2, C41.2, C42.2, C43.2, C44.2, C45.2, C46.2, C47.2, C48.2, C49.2, C50.2, C51.2, C52.2, C53.2, C54.2, C55.2, C56.2, C57.2, C58.2, C59.2, C60.2, C61.2, C62.2, C63.2, C64.2, C65.2, C66.2, C67.2, C68.2, C69.2, C70.2, C71.2, C72.2, C73.2, C74.2, C75.2, J1.12, J1.30, J2.6, J3.1 (VeeT), J3.10 (VeeR), J3.11 (VeeR), J3.14 (VeeR), J3.17 (VeeT), J3.20 (VeeT), J3.CAGE, J4.1, J4.8, R2.2, R4.2, R14.2, R17.2, U1.2 (GND), U2.2 (GND), U3.2 (GND), U4.B7 (GND), U4.B14 (GND), U4.C19 (GND), U4.D4 (GND), U4.F7 (GND), U4.F8 (GND), U4.F13 (GND), U4.F14 (GND), U4.G4 (GND), U4.G6 (GND), U4.G7 (GND), U4.G8 (GND), U4.G9 (GND), U4.G10 (GND), U4.G11 (GND), U4.G12 (GND), U4.G13 (GND), U4.G14 (GND), U4.G15 (GND), U4.G17 (GND), U4.H19 (GND), U4.J2 (GND), U4.J7 (GND), U4.J9 (GND), U4.J10 (GND), U4.J11 (GND), U4.J12 (GND), U4.J14 (GND), U4.K6 (GND), U4.K7 (GND), U4.K9 (GND), U4.K10 (GND), U4.K11 (GND), U4.K12 (GND), U4.K14 (GND), U4.K15 (GND), U4.L9 (GND), U4.L10 (GND), U4.L11 (GND), U4.L12 (GND), U4.M2 (GND), U4.M7 (GND), U4.M9 (GND), U4.M10 (GND), U4.M11 (GND), U4.M12 (GND), U4.M14 (GND), U4.M16 (GND), U4.N6 (GND), U4.N7 (GND), U4.N14 (GND), U4.N15 (GND), U4.P7 (GND), U4.P8 (GND), U4.P11 (GND), U4.P12 (GND), U4.P13 (GND), U4.P14 (GND), U4.R4 (CFG_2), U4.R19 (GND), U4.T4 (CFG_1), U4.U7 (GND), U4.U8 (GND), U4.U9 (GND), U4.U10 (GND), U4.U11 (GND), U4.U12 (GND), U4.U13 (GND), U4.U14 (GND), U4.V5 (GND), U4.V6 (GND), U4.V7 (GND), U4.V8 (GND), U4.V9 (GND), U4.V12 (GND), U4.V13 (GND), U4.V14 (GND), U4.V15 (GND), U4.V16 (GND), U4.V19 (GND), U4.V20 (GND), U4.W6 (GND), U4.W7 (GND), U4.W12 (GND), U4.W15 (GND), U4.W16 (GND), U4.W19 (GND), U4.Y7 (HDRXP0_D0CH1), U4.Y8 (HDRXN0_D0CH1), U5.2 (A1), U5.3 (A2), U5.12 (VSS), U5.21 (A0), U6.6 (VSS), U7.3 (GND), U8.3 (GND), Y1.3 (GND), Y2.3 (GND)
HOLDN: R10.1, U4.R2 (PB15A/HOLDN/DI/BUSY/CSSPIN/CEN)
INITN: R7.1, U4.V3 (INITN)
IRQ: J1.21, R20.1, U5.1 (~INT)
MISO: J1.40, J4.6, R15.1, U4.V2 (PB11A/D1/MISO/IO1)
MOSI: J1.39, J4.5, U4.W2 (PB11B/D0/MOSI/IO0)
OLT_PROGRAMN: R6.1, U4.W3 (PROGRAMN), U5.13 (IO1_0)
ONU_PROGRAMN: J4.7, U5.14 (IO1_1)
ONU_SCL: J4.2, R21.1, U6.8 (SC1)
ONU_SDA: J4.3, R22.1, U6.7 (SD1)
P7_BUF: R25.1, U7.4
P7_OE_N: R23.1, U5.8 (IO0_4), U7.1
P9_BUF: R26.1, U8.4
P9_OE_N: R24.1, U5.9 (IO0_5), U8.1
REF125_OE: R17.1, U5.11 (IO0_7), Y2.1 (OE)
REF155_OE: R16.1, U5.10 (IO0_6), Y1.1 (OE)
REFCLK_N: U4.Y12 (REFCLKN_D0), Y1.5 (OUT-), Y2.5 (OUT-)
REFCLK_P: U4.Y11 (REFCLKP_D0), Y1.4 (OUT+), Y2.4 (OUT+)
RSSI_TRIG: J1.18, U8.2
RX0_N: J3.12 (RD-), U4.Y6 (HDRXN0_D0CH0)
RX0_P: J3.13 (RD+), U4.Y5 (HDRXP0_D0CH0)
RX_RESET: J1.17, U7.2
SCL: J1.19, R18.1, U5.22 (SCL), U6.1 (SCL)
SDA: J1.20, R19.1, U5.23 (SDA), U6.2 (SDA)
SFP_LOS: J3.8 (RX_LOS), R29.1, U5.6 (IO0_2)
SFP_MOD_ABS: J3.6 (MOD_ABS), R30.1, U5.4 (IO0_0)
SFP_P7: J3.7 (RS0), R25.2
SFP_P9: J3.9 (RS1), R26.2
SFP_SCL: J3.5 (SCL), R31.1, U6.5 (SC0)
SFP_SDA: J3.4 (SDA), R32.1, U6.4 (SD0)
SFP_TX_DIS: J3.3 (TX_DISABLE), R28.1, U5.7 (IO0_3)
SFP_TX_FAULT: J3.2 (TX_FAULT), R27.1, U5.5 (IO0_1)
SN: J1.38, R9.1, U4.T2 (PB13A/SN/CSN)
SW_1V1: L1.1, U1.3 (SW)
SW_1V1_SD: L2.1, U2.3 (SW)
TCK: J2.2, R14.1, U4.T5 (TCK)
TDI: J2.3, R12.1, U4.R5 (TDI)
TDO: J2.4, U4.V4 (TDO)
TMS: J2.5, R13.1, U4.U5 (TMS)
TX0_N: J3.18 (TD+), U4.W5 (HDTXN0_D0CH0)
TX0_P: J3.19 (TD-), U4.W4 (HDTXP0_D0CH0)
TX_CLK: J1.1, RN3.7 (R2.2)
TX_CLK_S: RN3.2 (R2.1), U4.B19 (PT65B)
US0: J1.2, RN3.8 (R1.2)
US0_S: RN3.1 (R1.1), U4.A19 (PT67A)
US1: J1.4, RN2.5 (R4.2)
US1_S: RN2.4 (R4.1), U4.B17 (PT60A)
US2: J1.5, RN2.6 (R3.2)
US2_S: RN2.3 (R3.1), U4.A17 (PT62A)
US3: J1.6, RN2.7 (R2.2)
US3_S: RN2.2 (R2.1), U4.B16 (PT56B)
US4: J1.7, RN2.8 (R1.2)
US4_S: RN2.1 (R1.1), U4.B15 (PT51A)
US5: J1.8, RN1.5 (R4.2)
US5_S: RN1.4 (R4.1), U4.A14 (PT47A)
US6: J1.9, RN1.6 (R3.2)
US6_S: RN1.3 (R3.1), U4.B13 (PT42A)
US7: J1.10, RN1.7 (R2.2)
US7_S: RN1.2 (R2.1), U4.A13 (PT40B)

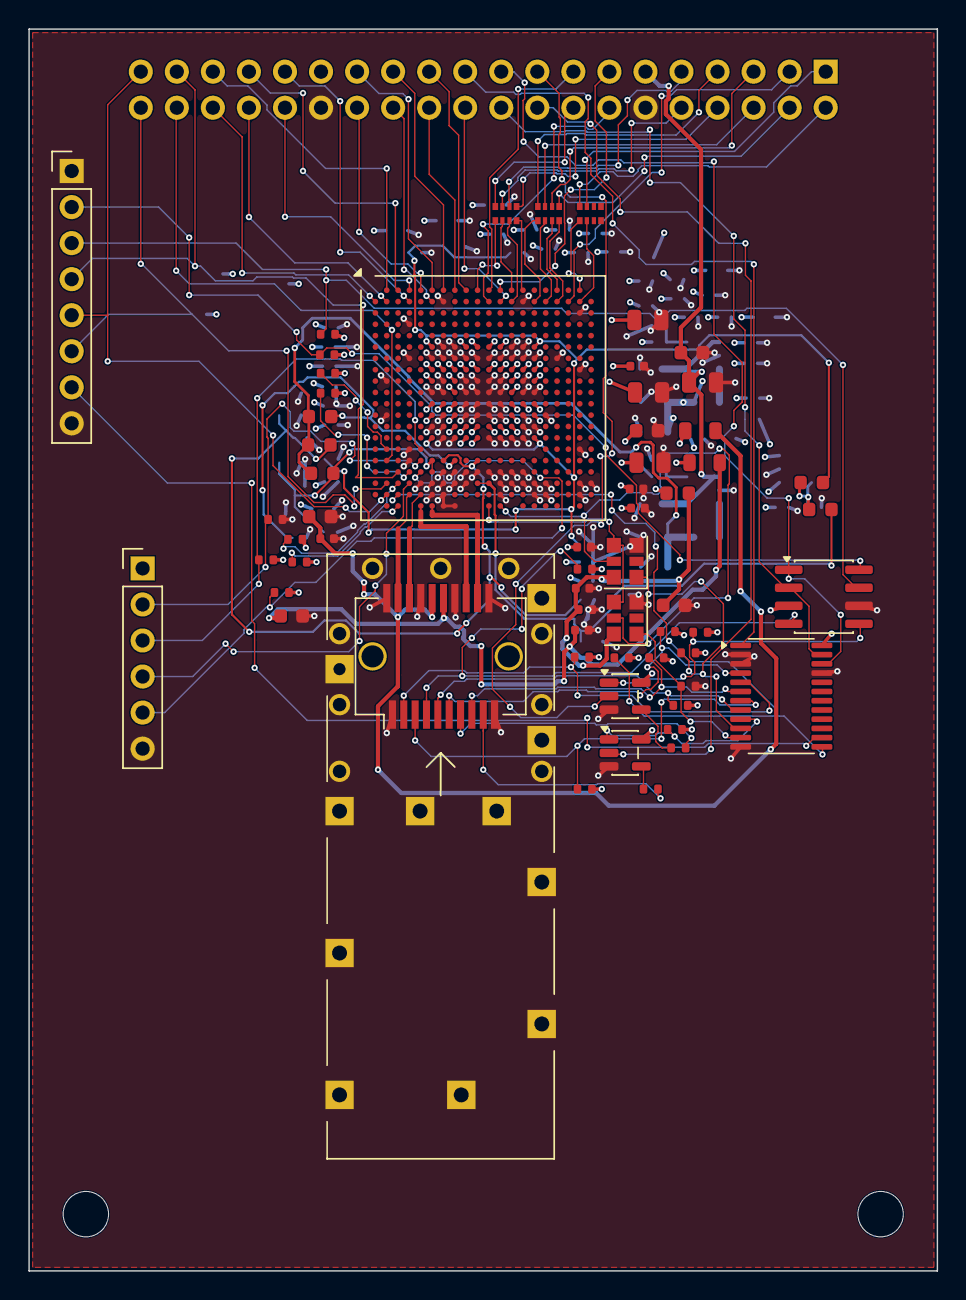
[picture p9: board olt.kicad_pcb from above]

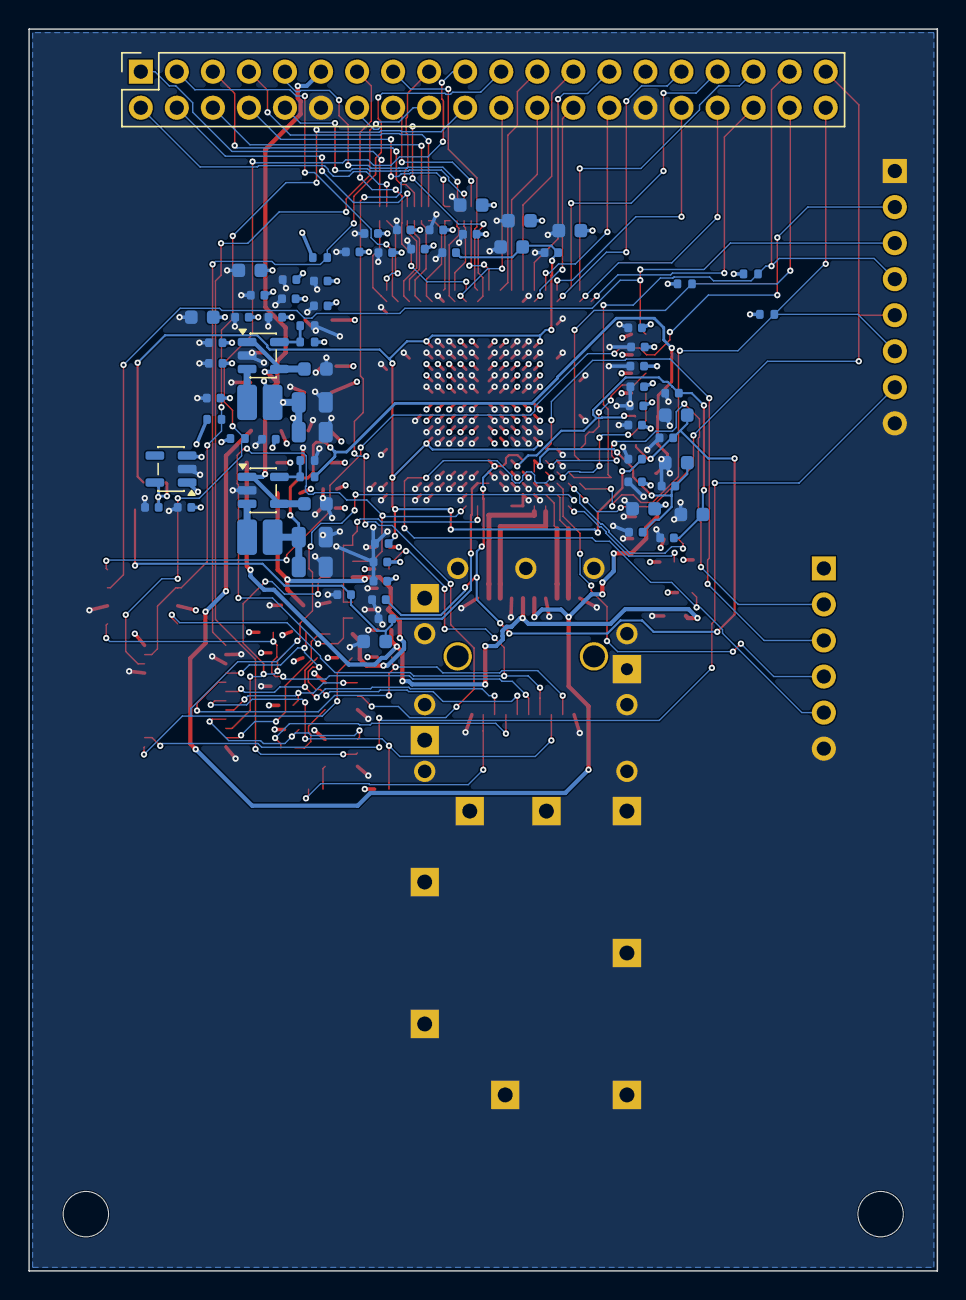
[picture p10: board olt.kicad_pcb from below]

Board: 4 copper layers, 64.0 x 87.5 mm, 136 parts (74 on the bottom side), 96 nets.
