alphaonex86/FPGA-ONU-1GPON-1GE/(commit log)

2026-10-31 GPON OLT MAC in simulation: GTC DS framer/deframer, US burst receiver
    SpinalHDL GTC downstream framer and deframer (1 byte/clock at 311.04 MHz)
    and upstream burst receiver (1 byte/clock at 155.52 MHz) with a shared GEM
    delineator, checked against G.984.3 vectors and a Scala ONU model.
    Quartus fit/timing bench script and the CPU dual-issue benchmark.
2026-11-01 PCB: ECP5 SerDes bridge boards (OLT and ONU) for the DE25-Nano
    Generated KiCad 10 schematics and 4-layer boards (JLCPCB) from pcb/gen:
    gen.py -> place.py --force [olt|onu] -> route.sh (freerouting, then KRT
    on the leftovers, then outer GND pours and DRC). Both boards: 0 DRC
    errors, 0 unconnected, clean schematic parity and ERC.
    [olt.kicad_pcb, olt.kicad_sch, onu.kicad_pcb, onu.kicad_sch]
2026-11-01 PCB: own 3D models for the parts kicad-packages3d lacks
    ECP5 caBGA-381, SiT9121 oscillator and SFP cage: KiCad footprints name
    models its 3D library does not ship, and vendor models cannot be
    redistributed here. mk3d.py writes faceted STEP (pure Python) with balls,
    pads and pins taken from the KiCad footprints, into pcb/lib/3d, and points
    the boards at them; place.py does the same on regeneration.
    [olt.kicad_pcb, onu.kicad_pcb]
2026-11-01 PCB: zero DRC warnings on both boards
    finish_footprint (generation and finish.py alike): references and passive
    outlines on the fab layer, field text other than the value hidden (MPN was
    printed on silk), own 3D models. finish.py also removes vias and track ends
    left dangling by the hand escapes, cutting them from the file text since
    pcbnew Remove() breaks its SWIG state. gen.py always applies write_project,
    which declares lib_footprint_mismatch ignored (silk moved on purpose).
    KiCad local history (.history/) ignored.
    [olt.kicad_pcb, onu.kicad_pcb]
2026-11-01 ONU board: optics block (SY88236L, TPS61391, AD5593R, X100DG BOSA)
    - SY88236LMG burst laser driver + limiting amp next to the BOSA TX leads;
    burst enable through an SN65LVDT2, TXDIS pulled up (laser dark until the
    ECP5 is configured), SD mode with JAM squelch.
    - TPS61391 APD bias (37 V default, 18-55 V by DAC), HV netclass 0.2 mm.
    - AD5593R (I2C 0x10): APC/MOD/APD trim DACs, bias/mod/APD/RSSI ADCs.
    - BOSA footprint (pcb/lib/bridge.pretty) + 3D model: placeholder pad order
    and geometry until the X100DG part is measured.
    - TD/RD pairs hand-routed; DIN P/N swapped (ECP5 TXINVPOL = Invert).
    - ONU board: DRC 0, unconnected 0, parity 0, ERC 0.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
    [onu.kicad_pcb, onu.kicad_sch]
2026-11-01 pcb: BOSA footprint from the X100DG land photo
    Both TO cans stand under the BOSA body: TX TO-56 4 leads in a + on a 2.0 mm
    circle, RX TO-46 4 leads in an X on a 2.54 mm circle plus a centre lead, 8.5 mm
    apart (scaled from the photo, lead order still unknown). New 3D model, ONU
    board re-placed and re-routed: DRC 0, unconnected 0, parity 0, ERC 0.
    [onu.kicad_pcb]
2026-11-01 README: DE25-Standard + own HSMC card replaces the Nano + ECP5 bridges
    The DE25-Standard HSMC connector brings 4 GTS transceivers (up to 10 Gb/s), so
    the GPON lanes reach the FPGA directly; one HSMC card carries the ONU BOSA
    optics, an SFP+ cage for the OLT module and an SFP+ cage for Ethernet
    (copper 1000BASE-T SFP). The ECP5 bridge boards stay as the Nano alternative.
2026-11-01 Split the tree per board: common/, agilex5/, de25-nano/
    - common/: RTL and tests (hw/), KiCad generator and shared parts library
    (pcb/gen, pcb/lib), sniffer photo.
    - agilex5/: Quartus benches; quartus_core.sh takes DEVICE (default the
    DE25-Standard part); sbt also compiles agilex5/hw/spinal (vendor wrappers).
    - de25-nano/pcb/{olt,onu}: the ECP5 bridge boards.
    - pcb/gen/paths.py maps each board to its folder; KiCad library and 3D paths
    now point at common/pcb/lib. Both boards: DRC 0, unconnected 0, parity 0, ERC 0.
    [olt.kicad_pcb, olt.kicad_sch, onu.kicad_pcb, onu.kicad_sch]
2026-11-01 HSMC card for the DE25-Standard: OLT SFP+, Ethernet SFP+, GPON ONU BOSA
    Generated, placed and routed (DRC, ERC, schematic parity clean). HSMC pinout,
    symbol and card-side footprint from the HSMC spec; four GTS lanes, both refclk
    inputs (XO and VCXO 155.52 MHz), independent laser max-burst cutoff.
    Plane vias: also try along the pad axis, reuse a same-net via as last resort.
    [hsmc.kicad_pcb, hsmc.kicad_sch]
2026-11-01 HSMC card: fix the open risks, reroute
    - GTS pairs routed by code (hsmc_pairs): 100 ohm, TX on F.Cu over GND, RX on
    B.Cu over +3V3 then F.Cu; P/N swaps at the connector undone by GTS polarity
    inversion (OLT/ETH/ONU RX).
    - Burst enable DC-coupled to the SN65LVDT2 (R49 DNP fallback).
    - Laser max-burst cutoff: retriggerable 74LVC1G123 one-shot (~1.5 ms, longer
    than an EPON grant) + 74LVC1G97 gate, no false trip on back-to-back bursts.
    - Cages on +3V3_SFP from a TPS563201 12 V buck (HSMC 12 V pins 88/94/100;
    the DE25 HSMC 12V header must be on pins 2-3); their parts on that plane.
    - Refclk oscillators LVPECL with 150 ohm loads: LVDS can fall under the GTS
    0.6 Vpp minimum.
    - pcbgen: pla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
    [hsmc.kicad_pcb, hsmc.kicad_sch]
2026-11-01 GPON OLT: ONU activation and static BWmap (OltScheduler)
    Upstream clock domain: SN request (Alloc-ID 254) with Upstream_Overhead,
    Assign_ONU-ID (same SN keeps its ONU-ID), ranging request, EqD = Teqd - round
    trip, Ranging_Time, then one grant per active ONU and frame with PLOAMu.
    Request frames sit between configurable empty frames (quiet window); after
    three failed ranging tries the ONU-ID is taken back with Deactivate_ONU-ID.
    PLOAMu outside activation go to the CPU (No_message dropped); CPU PLOAMs are
    merged downstream after ours.
    The upstream receiver now reports the grant time of each burst, so a report is
    matched to its grant.
    Test: scheduler + receiver against four Scala ONU models a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
2026-11-01 GTS lanes fit on the DE25-Standard; XO to 156.25 MHz
    Quartus 26.1.1 fit of every HSMC card lane at its rate from its refclk pin
    (agilex5/gts: gen_ip.sh variants, hsmc_lanes.sv, fit.sh). Ethernet 1.25 Gb/s
    is illegal from 155.52 MHz (TX and CDR), PON CDRs need a PON-family refclk:
    XO becomes 156.25 MHz (Ethernet), the VCXO feeds every PON lane. Dual simplex
    TX/RX variants are refused on one channel, so PON lanes run duplex at 2488.32
    with the 1244.16 direction 2x oversampled.
    [hsmc.kicad_pcb, hsmc.kicad_sch]
2026-11-01 OLT MAC top: framer, scheduler and burst receiver across the 2:1 clock domains
    OltMac puts the downstream framer at 311.04 MHz and the activation scheduler
    and upstream receiver at 155.52 MHz (same source); the crossings need no FIFO.
    OltMacTest runs the activation scenario end to end through the downstream line
    and an ONU deframer; the ONU models and the scenario are shared with
    OltSchedulerTest. quartus_core.sh takes a second clock (CLK2) and reports the
    worst setup slack: 1.9K ALM, 319/185 MHz, slack +0.08 ns.
2026-11-01 OLT DBA: T-CONT table, DBRu mode 0 demand, grants in each ONU's burst
    The CPU writes a T-CONT table sorted by ONU-ID (Alloc-ID, fixed, max, DBRu);
    each frame every active ONU gets its default allocation then its T-CONTs in
    one burst: fixed + min(demand, max - fixed), clipped to the frame. Demand is
    the last mode 0 report (Table 8-1 decode x reporting block) minus what was
    granted since. The table count is taken once per frame; an unsorted table
    raises tableError. OltDbaTest drives bursty, steady and fixed-only T-CONTs
    through multi-allocation bursts. OltMac: 2.3K ALM, 312/176 MHz.
2026-11-01 OLT CPU registers: APB3 + IRQ, generated C header
    OltRegs (RegIf) inside OltMac replaces the raw CPU ports: configuration,
    T-CONT table writes, downstream PLOAM queue, upstream PLOAM and event queues
    popped on read, ONU-ID release, sticky errors cleared by writing 1 (lost
    queue entries included), interrupt enables, GEM counters. Generation also
    writes out/rtl/olt_regs.h. OltMacTest now runs the activation from a CPU
    model over APB and the interrupt, and grants a T-CONT written through the
    registers. 2.3K ALM, 311/168 MHz.
2026-11-01 OLT optics burst reset before each upstream burst
    GtcUsDeframer drives rxReset for RX_RESET.bytes upstream bytes, ending
    RX_RESET.lead bytes before the delimiter search window of each new burst
    (only between bursts), for the burst-mode receiver of OLT SFP modules; the
    module's pin and timing are set by the CPU from its datasheet. GtcUsTest
    checks every pulse position.
2026-11-01 GPON ONU MAC: activation O1-O7, fixed PLOAM set in HW, bit-timed upstream bursts
    OnuPloam: G.984.3 states and TO1/TO2, Upstream_Overhead, Extended_Burst_Length,
    Assign_ONU-ID, Ranging_Time, Deactivate_ONU-ID, Disable_Serial_Number, POPUP,
    Assign_Alloc-ID table, Configure_Port-ID, Request_Password (3 Passwords),
    Acknowledge of the acknowledge-required types; every PLOAM addressed to us
    also goes to the CPU. GtcUsFramer: jobs at their ONU bit time, bit-level
    burst overhead, PLOu, PLOAMu, DBRu, idle GEM, burst enable per line bit.
    OnuMac: deframer 311.04 / upstream 155.52 MHz; upstream time anchored to the
    downstream frame start to the bit (half clock, PSync alignment), so POPUP keeps
    the EqD.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
2026-11-01 OLT: SN period counts frames outside request windows
    A period no longer than a window chained SN windows back to back and active
    ONUs got no grant at all; now snPeriod normal frames always separate them.
2026-11-01 OLT board top: GTS lane, HPS bridge, board registers, fit with timing met
    - GtsPonLanes: MAC lines <-> GTS words (bit order, 2x upstream oversampling).
    - OltBoard/OltBoardCore: HPS lightweight AXI4 -> APB3; OltRegs across the
    clocks with an error answer while the lane is down; BoardRegs (GTS reset and
    status, OLT SFP pins, I2C, pin events + IRQ; board_regs.h). Laser forced off
    while the PON clocks are down.
    - GTS: single width, srcss with 4 lanes; PON clocks from the clock network
    divider (the IP makes tx_clkout2 asynchronous to tx_clkout).
    - fit.sh: any top (hsmc_lanes, OltBoard), per-lane pin names, STA with worst
    setup/hold, fails on negative slack or an unconstrained clock.
    - T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
    [hsmc_lanes.sv]
2026-11-01 GEM CPU queues for OMCI on the OLT board
    - GemCpuQueues (board-neutral): downstream packets written by the CPU leave
    whole, one byte per clock, only once all their words are queued; upstream
    GEM fragments as packed words plus a descriptor (port, Alloc-ID, bytes,
    end, cut, truncated); sticky errors and an IRQ; gem_queues.h.
    - GtcUsDeframer/OltMac expose the fragment cut pulse.
    - OltBoardCore: queues at 0x200 with their own IRQ, reset with the PON
    clocks, error answer while the lane is down, unmapped space answers error.
    - Fit: 3.8K ALM, setup slack +0.061 ns (TX read enable fed by registers only).
2026-11-01 ONU board top: OnuMac on the BOSA lanes, VCXO loop, optics pins; PonBoard fits both sides
    BoardCommon shares the GTS lane registers, events, HPS bridge and PON domains
    between the OLT and ONU board cores. VcxoTracker keeps the ONU clock on the
    recovered downstream clock (Gray phase detector, PI, sigma-delta pin).
    PonBoard: 7.4K ALMs, setup slack +0.006 ns with the HSMC card pins placed.
2026-11-01 VCXO loop: DDMTD phase detector, 6.7 ps steps instead of whole clocks
    The ONU's upstream timing follows the VCXO loop's phase, and an OLT re-ranges
    past 4 bits of drift and deactivates past 8 (G.984.3 Table 10-2, Broadcom Maple
    defaults). The old detector counted whole 311.04 MHz clocks (4 bits each).
    VcxoTracker now samples both clocks, halved by toggle flops (a GTS clock output
    cannot reach a data input), with a 155.357 MHz helper from an IOPLL on CLOCK_50
    (promoted to a global clock): beats every ~955 helper cycles, 6.7 ps steps,
    +-520 ppm capture, PI per beat. Simulated against a VCXO model (100 ppm off,
    1 ps rms jitter): 0.025 bit of upstream phase wander peak to peak.
    PonBoard: 7494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
2026-11-01 ONU: downstream AES-128 decryption and FEC parity skipping
    Own AES-128 core (on-the-fly key expansion, 2 clocks per round, 2 blocks in
    flight). GemDecrypt starts each encrypted fragment's keystream at its header
    (crypto-counter = superframe and frame position, through FEC parity) while
    the bytes wait in a RAM; late keystream drops the fragment as cut. OnuPloam
    keeps the encrypted Port-IDs (shared IdSet with the Alloc-IDs), passes
    Key_Switching_Time and Request_Key; the CPU writes the shadow key. The
    deframer skips FEC parity bytes when the Ident FEC bit is set and flywheels
    the superframe counter. Checked against G.984.3 A.2.2, A.2.3 and A.3.
    PonBoard fit: 9.2K ALMs, setup slack +0.061 ns.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
2026-11-01 ONU: downstream FEC decoding, RS(255,239)
    FecDecoder between the descrambler and the field parsing: syndromes per
    codeword, inversionless Berlekamp-Massey and the evaluator (3 clocks a
    step), Chien search and Forney on the bytes leaving a 340-clock delay RAM;
    up to 8 byte errors corrected per codeword, uncorrectable ones counted. FEC
    turns on after two frames with the Ident FEC bit (one flipped bit cannot
    mis-parse a frame). Codeword, corrected byte/codeword and uncorrectable
    counters in OnuRegs for the OMCI FEC PM. PonBoard fit: 10.7K ALMs, setup
    slack +0.206 ns.
2026-11-01 OLT downstream FEC: RS(255,239) encoder in the GTC framer
    CTRL.dsFec turns it on at a frame boundary (Ident FEC bit); the data
    position pauses on the parity slots, BIP and CRC skip them. Loopback
    checks every codeword's parity against the model; the OLT-ONU closed loop
    runs with DS FEC on, no uncorrectable codeword. FecDecoder: decoding
    flags start cleared. PonBoard fit 10.8K ALMs, slack +0.192 ns.
2026-11-01 ONU upstream FEC: RS(255,239) parity in the burst framer
    When the burst's first grant sets Use_FEC (not on serial number or
    ranging grants): codewords from the BIP byte, parity after every 239
    data bytes and at the burst end (shorter last codeword, fewer than 17
    bytes sent as zeros), Ind FEC bit, BIP without parity. Each grant's data
    bytes are computed when it starts, the next job seen through a one-job
    lookahead. GtcUsFecTest parses the bursts with a Scala OLT model. The
    'FEC requested' ONU error bit is gone. PonBoard fit 11.1K ALMs, slack
    +0.129 ns.
2026-11-01 Ethernet port: 8b/10b, comma aligner and taxi 1G MAC + PCS
    Own 8b/10b encoder/decoder (tables built at elaboration from the 802.3
    clause 36 sub-blocks, invalid or disparity-errored words as /V/) and a
    comma aligner for the raw 10-bit GTS lane; taxi (submodule, CERN-OHL-S)
    provides the 1000BASE-X/SGMII PCS with autonegotiation and the 1G MAC
    through a flat SV wrapper. Tests: code table values and properties,
    alignment at any bit offset, two ports back to back.
    [eth_mac_1g_basex.sv]
2026-11-01 Board: Ethernet port on its GTS lane, cage pins and HPS frame queues
    EthBoardCore on a third lightweight-bridge slave: board registers (lane,
    SFP cage, PCS state, SGMII select; eth_board_regs.h) and GemCpuQueues as
    frame queues (a bad frame comes as cut). The SFP cage registers are
    shared with the OLT side. The lane's tx/rx clocks feed back into it,
    declared asynchronous; the black-box RTL (taxi) goes to fit.sh through
    out/rtl/PonBoard.sources. ETH cage pins from the manual HSMC table.
    EthBoardTest: CPU -> looped-back lane -> CPU. PonBoard fit 13.0K ALMs,
    slack +0.235 ns.
2026-11-02 ONU L2 bridge, data T-CONT stream, real DBRu; Ethernet end to end OLT <-> ONU
    - GtcUsFramer: one GEM stream per T-CONT, each continuing its own packet
    - OnuMac: all downstream GEM out with the OMCI Port-ID (bridge forces it to the CPU),
    data stream in DATA_ALLOC, DBRu reports from the queues' backlog (DbruReporter:
    blocks rounded up, G.984.3 Table 8-1; mode 1 all green)
    - OnuBoardCore: bridge at 0x300; PonBoard routes the Ethernet port to either bridge
    - bridge: register after the Port-ID action RAM (311.04 MHz on the ONU side)
    - OnuMacTest: Ethernet frames through both bridges end to end, both ways
2026-11-02 Upstream by VLAN/PCP to 4 T-CONT queues
    - bridge: VLAN or untagged entry -> Port-ID directly or by an 802.1p mapper (PCP),
    Port-ID -> queue; a mover fills one queue per T-CONT, a full one drops without
    blocking the others; action RAM output registered (ONU side at 311.04 MHz)
    - OnuMac: 4 data streams, DATA_ALLOC_0-3, DBRu per stream
    - OnuMacTest: a second T-CONT granted by our OLT carries a VLAN 10 frame end to end
2026-11-02 Bridge VLAN treatments (G.988 ME 171 subset) and lossless table writes
    - VlanRewrite: push, pop, translate of the outer tag, PCP set or kept, optional FCS;
    output frames gap-free (the removed tag's hole buffered)
    - bridge: upstream treatment by the VLAN/untagged entry, downstream by outer VID;
    upstream FCS now computed after the rewrite at the queue output
    - fix: CPU table writes crossed by FlowCCByToggle were lost or shifted when written
    back to back; now a handshake per table, APB stalled meanwhile, the crossing reset
    with its table's domain so a lane going down cannot hold the bus
2026-11-02 Frame parser for the flow engine (VLAN, PPPoE, IPv4 5-tuple, offload verdict); fit numbers with the bridge
2026-11-02 Flow cache (2-way hash in block RAM) and flow rewriter (MACs, PPPoE add/strip, NAPT, TTL, incremental checksums)
2026-11-02 Flow offload in the GEM <-> Ethernet bridge, each way: classifier at the input, rewrite at the output
2026-11-02 Router slow path: flows-mode misses to LAN/WAN CPU frame queues, CPU frames out of both sides
2026-11-02 Per-flow hit bits read and cleared by the CPU (flowtable offload stats); registered sender queue output
2026-11-02 IPv6 routed flow offload (own table, hop limit, PPP 0x0057); flat XOR hash; rewriter indexes counted, output registered
2026-11-02 Frame parser: control protocol verdict (ARP, PPPoE discovery, LCP/IPCP, EAPOL, LLDP, IGMP, DHCP/DHCPv6, ICMPv6)
2026-11-02 Rate-limited control frame queues; small RAMs to MLABs
    Control frames (ARP, PPPoE discovery and LCP, DHCP, ICMPv6, IGMP, EAPOL,
    LLDP, slow protocols) leave the CPU path through their own token bucket
    (CONTROL_RATE, drops in CONTROL_DROPS) into receive-only GemCpuQueues at
    0x600/0x700 on each board side, with their own interrupts.
    Spinal RAMs read old data during a write, which keeps every RAM out of the
    MLABs: single-clock FIFOs and egress tables (CPU writes now wait out a
    read) get no_rw_check, the small ones MLAB.
2026-11-02 README: control frame queues
2026-11-02 Bridge: registered descriptor room check; PonBoard fits with the flow engine
    The room check (Gray occupancy + descriptors in flight) was the 311.04 MHz
    critical path in the ONU; registered, it keeps one slot spare for the push
    it has not seen. PonBoard: 32.7K ALMs, 333/358 M20K, setup slack +0.019 ns.
2026-11-02 EPON MAC: clause 36 PCS and clause 65 LLID preamble
    EponMacTx: LLID preamble with its CRC-8, FCS, /T/R/(R), IPG, /I1/ or /I2/ by
    the running disparity, /V/ for a byte missing in a frame. EponMacRx: comma
    alignment, 8b/10b, preamble check (dropped when bad), LLID and mode per
    byte, FCS and code check. EponMacTest: back to back at every bit slip.
2026-11-02 EPON ONU MPCP
    OnuMpcp: local time set by the MPCPDU timestamps (drift past 12 TQ flagged),
    discovery (REGISTER_REQ at a random offset of the window), REGISTER,
    REGISTER_ACK in the first grant, GATE grants in a FIFO (late ones
    dropped), bursts from the grant start to its end less laserOff with
    REPORT then the data frames that fit, deregistration by the OLT, the
    MPCP timeout or the ONU itself. OnuMpcpTest: against an OLT model over
    EPON MACs and a fibre, the laser dark between bursts.
2026-11-02 EPON MAC tops with CPU registers; data frames carry their FCS
    EponOnuMac / EponOltMac: MAC, MPCP and APB3 registers (epon_onu_regs.h,
    epon_olt_regs.h): configuration, registration state and LLID, OLT event
    queue, sticky errors, frame counters, interrupts. MAC Control frames are
    kept off dataRx on both sides. Data frames reach the MAC with their FCS, as
    GEM frames do (EponTxByte.fcs appends one, for MPCPDUs).
    Timing at 125 MHz: ONU grant planning in three steps (registered head,
    discovery offset, burst times) and the remaining burst time registered;
    OLT earliest grant time registered. ONU 1325 ALMs 211 MHz, OLT 2421 ALMs
    142 MHz. EponMacRegsTest: two ONUs and the OLT run through their registe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
2026-11-02 EPON on the Ethernet bridges: LLID as Port-ID, REPORT from the queues
    EponGem: received frames as GEM fragments (Port-ID = LLID, 0xFFF the
    broadcast LLID), OLT GEM packets as frames of their LLID, the ONU's bridge
    queues into its grants with a REPORT that always covers the frame waiting
    (an under-report left it waiting forever). Mpcp.frameCost shared by the
    ONU's fit check and the REPORT. EponBridgeTest: OLT and ONU MACs with their
    bridges, frames end to end both ways, broadcast VLAN, a frame in queue 2.
2026-11-02 GTS: OLT cage lane with two DR profiles, GPON and 1.25 Gb/s
    gen_ip.sh: olt_1g25 (1250 Mb/s, XO refclk) beside olt, and the GTS dynamic
    reconfiguration controller. fit.sh dr_lane: both PMA-clocked Direct PHY
    IPs on the OLT pins in one DR group (quartus_tlg generates dr_top), each on
    its own refclk; fit and timing clean (2130 ALMs, setup +1.515 ns). The
    reconfigurable PHY mode is system-PLL only, so separate IPs are used. Under
    DR the RX words come on each profile's rx_clkout. The controller takes 38
    M20K, more than PonBoard has left: not in the board top yet.
2026-11-02 EPON OLT: optics receiver reset before each planned burst
    OltMpcp queues the planned arrivals (GATE grants, discovery windows) and
    pulses rxReset ending RX_RESET.lead TQ before each; EponOltMac exposes it
    for the module's burst reset pin, ERRORS.resetLost if the queue is full.
    OltMpcpTest: a reset before every burst at a constant distance, never in
    one. OLT MAC 2529 ALMs, 141 MHz.
2026-11-02 Board: EPON OLT on the OLT cage lane's DR profile
    The OLT lane is now dr_top (GPON and 1.25 Gb/s profiles) with its DR
    controller; the active profile (one_hot_sel) picks the core clock through
    a clock mux before pon_clocks, the MAC (OltMac or EponOltMac) and the
    upstream path into the bridge. Received words cross from each profile's
    rx clock (RxWordCC). The OLT bridge and CPU queues receive on the ds
    clock; GPON upstream GEM is taken once per upstream clock. HPS windows
    grow to 4 KB: 0x800 EPON OLT registers, 0x900 DR controller CSRs.
    Board bridges keep 1K IPv4 flows per direction to make room for the DR
    controller's block RAM.
    Timing: the 1.25G profile clock is redefined at 125 MHz (its IP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
2026-11-02 HSMC card: 156.25 MHz VCXO for the loop-timed EPON ONU
    The 156.25 MHz refclk becomes a VCXO tuned by the FPGA (VCXO156_PWM on HSMC
    pin 122, same RC filter as the 155.52 MHz one), so an EPON ONU on the BOSA
    transmits loop-timed like a stock one. Re-placed and re-routed: DRC and ERC
    clean, schematic parity 0. route.sh reruns freerouting from the nearly routed
    board when KRT leaves opens (closed the last one here).
    [hsmc.kicad_pcb, hsmc.kicad_sch]
2026-11-02 EPON ONU on the BOSA lane: one DR group for both PON sides
    - One quartus_tlg dr_top for the three PON lanes (OLT, ONU, burst enable)
    and one intel_dr_gts (3 channels, 6 profiles, 4 combinations): each PON
    side switches between GPON and 1.25 Gb/s on its own; the burst enable lane
    follows the ONU (TX reset forced with it, on the ONU core clock in both
    profiles). dr_lane.sv went away in 24eb460; fit.sh drops its mode.
    - OnuBoardCore: EPON ONU MAC on the 1.25 Gb/s profile with the same bridge
    and CPU queues; registers at 0x800, PROFILE and VCXO156 board registers.
    The 156.25 MHz refclk is now a VCXO (vcxo156Pwm, HSMC 122) with its own
    VcxoTracker on a second helper PLL output (62.1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
2026-11-02 PonBoard in the Terasic GHRD with the HPS: fits and meets timing
    fit.sh ghrd top: de25-standard/ghrd/prepare.sh upgrades the DE25-Standard
    GHRD to Quartus 26.1 outside this repository and keeps its qsf;
    qsys_top.tcl removes its JTAG debug masters with the HPS F2H/F2SDRAM
    bridges only they used, shrinks its on-chip RAM to 4 KB and exports
    PonBoard's three lightweight windows; ghrd_top.py wires PonBoard into
    golden_top (IRQs on f2h_irq1, GHRD 100 MHz clock). 41.7K ALMs, 336 M20K,
    setup +0.001 ns.
    fit.sh: the DR loop variable no longer overwrites the SDC hierarchy
    prefix, dr_top only through its qip (its SDC applied, checked),
    CLOCK1_50 at 1.8 V. GemCpuQueues: the async FIFO ready only selects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
2026-11-02 GPON sniffer: card routed, RTL for the Agilex and the ECP5
    Passive tap on one ONU's drop: two BOSA receive cans, ECP5 SerDes card on the
    DE25-Nano GPIO. Card generated by common/pcb/gen and routed (KRT, then
    close_opens on the last 5 nets): KiCad 0 errors, 0 unconnected.
    RTL (pon.sniffer, vendor-neutral): SnifferDs filters the downstream to one
    ONU (PLOAM by ONU-ID, BWmap by Alloc-ID map, GEM by Port-ID map, still
    ciphered with the crypto-counter); SnifferUs records each upstream burst;
    RecordWriter frames the records. SnifferBridge is the ECP5 fabric: VCXO loop
    on the DS crossing FIFO's fill, 2x upstream phase pick, gearboxes to the
    77.76 MHz DDR pins. sniffer/ecp5: Verilog top around it,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
    [sniffer.kicad_pcb, sniffer.kicad_sch]
2026-11-05 SFP cage 0 universal: OLT module or a normal SFP; cages renamed SFP0/SFP1
    Cage 0 (GTS lane sfp0, was olt) takes a GPON or EPON OLT module or a
    normal SFP: OLT board register ETH, set while the lane is reset, puts an
    EthPort on the 1.25 Gb/s profile instead of the EPON OLT MAC, its frames to
    CPU queues at 0xA00 of the OLT window, its interrupt on f2h_irq1 bit 16.
    Cage 1 (sfp1, was eth) stays the Ethernet port's. Swapping the cores
    between cages is impossible: a GTS HIO user clock reaches no soft clock
    mux (fit error 170084). EthCpuQueues: the frame queue wiring shared by
    both Ethernet ports. OltBoardTest: three frames CPU -> cage 0 Ethernet ->
    lane -> CPU.
    fit.sh: the DR loop gave each IP on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
    [hsmc_lanes.sv]
2026-11-05 HSMC card: cages SFP0/SFP1, upstream sniffer receiver in a south strip
    Cages renamed SFP0 (OLT module or a normal SFP) and SFP1 (Ethernet).
    Upstream sniffer (receive only) on the burst enable lane's free GTS RX
    (HSMC lane 0): XL-BCB2111 1310 nm receive can at the south edge, its fibre
    over it, SY88349 limiting amp with swapped inputs (no crossing; the
    connector P/N swap undoes it, so no GTS inversion), its own TPS61391 APD
    bias and a second AD5593R (0x11) on the ONU I2C bus, SD on HSMC pin 126.
    The pair is hand-routed beside the ONU RX pair. The block gets its own
    10 mm strip: the card is 80 x 88 mm with the corner over the host cut
    away (in the ONU optics area it left the router 1-6 opens).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
    [hsmc.kicad_pcb, hsmc.kicad_sch]
2026-11-05 Sniffer board: re-route the APD bias nets to the HV clearance
    The HV net class now matches the prefixed APD nets (*HV_*), which showed 73
    clearance errors on this board (routed before the change). Ripped the 13
    bias nets that broke it and re-routed them with freerouting around the
    kept copper. The upstream LA input pair stays as it was (13.7 / 18.8 mm);
    one of its segments is moved 0.1 mm away from C99's HV pad. Also dropped
    the GND stub and via beside each TPS61391 SW pin (generated before
    plane_vias checked prefixed HV nets); the pour connects those pins.
    DRC 0 errors, 0 unconnected, schematic parity clean.
    [sniffer.kicad_pcb]
2026-11-05 Sniffer in PonBoard, per-side DR, fresh fit folders
    - SnifferCore on the ONU side (window 0x900, sniffer_regs.h, last IRQ):
    SnifferDs on the OnuMac deframer's fields (DsFields), SnifferUs on the
    burst enable lane's RX (ben_tx/ben_1g25 now duplex, lock-to-ref), records
    as 32-bit words to the CPU; enable forces LASER_DIS. BEN RX pin AT135,
    US_SD PIN_Y18. RecordWriter head push registered for 311.04 MHz.
    - DR: four full combinations (GPON or 1.25G per side), each IP in two, so
    one side switches alone; partial combinations of startup IPs failed the
    GHRD fit (23098).
    - fit.sh empties its own DIR (marker) and refuses other non-empty ones: a
    reused fit folder crashed Quartus 26.1.1 (2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
2026-11-05 HSMC card: upstream sniffer strip removed (SFP0 OLT module instead)
    The upstream sniffer is now a GPON OLT module in SFP0 (operator), so the
    card's own receiver goes: XL-BCB2111 RX can, SY88349, APD bias, second
    AD5593R (0x11), US_SD (HSMC pin 126) and the lane 0 RX pair. Cut from the
    routed board (41 parts, their tracks and dangling stubs), card 80 x 79 mm
    with the corner over the host still cut, second mounting hole moved clear
    of the BOSA; boards.py / place.py match. DRC as before: 0 unconnected,
    schematic parity clean, the same 6 silk edge warnings.
    [hsmc.kicad_pcb, hsmc.kicad_sch]
2026-11-05 Upstream sniffer on SFP0, flow table ways in one RAM
    - Sniffer upstream from cage 0's receiver (a GPON OLT module on the tap,
    operator): SFP0 RX words through RxWordCC into the ONU core clock, as the
    OLT does; while sniffing, cage 0 TX_DIS is forced in hardware (the tap
    must not see our OLT's downstream), with the ONU laser as before
    (OnuBoardTest checks both). The burst enable lane is TX only again; its
    RX pin and US_SD are gone.
    - FlowTable: both ways in one RAM (bucket ## way), read on two clocks
    through one comparator: the IPv6 entries (375 bits) fill an M20K's width,
    not its depth, so each IPv6 table halves (20 -> 10 M20K, 4 tables).
    Lookups one at a time (frames >= 64 c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
2026-11-05 route.py: several routing strategies in parallel, the best kept
    Replaces route.sh (operator: try several routers in code, keep the best
    per board). Four strategies, each on its own copy of the placed board, in
    parallel at nice 19: the former chain (freerouting via-cost 10, KRT,
    finish, freerouting if still open), the same with via-cost 50, KRT first,
    and freerouting + KRT + mlroute on what stays open. Scored by
    route_score.py (unconnected, DRC errors, vias, length); the input board
    competes, so a worse result never replaces it. A failing step is reported
    and its logs kept (route.sh's "|| true" hid them); autoroute's exit 1
    "nothing to save" is a no-improvement result, not a failure.
    Checked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
    [route.py]
2026-11-05 Sniffer: burst reset of the tap's OLT module from the captured BWmap
    BurstReset plans a pulse before each burst of the tapped ONU: a kept BWmap
    entry (good CRC) not contiguous with the frame's previous one (StartTime =
    previous StopTime + 1 continues a burst, as GtcUsFramer) is due at its
    record time + RESET_OFFSET + 2 StartTime clocks; the pulse starts RESET_TIMING
    lead clocks before and lasts width (0: off). Plans queue (EqD spans frames);
    one already past or with the queue full counts in RESET_LOST; disable
    flushes them. The CPU learns the offset from the records (burst time -
    entry time - 2 StartTime). While sniffing, cage 0's RS pins in burst reset
    mode follow it instead of the OLT MAC'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
2026-11-05 Sniffer HPS tool: records, auto-configuration, burst reset offset learning
    Portable C core (register callbacks) reads the DS/US record words, decodes
    PLOAM/BWmap/GEM (OMCI header)/burst records, keeps the tapped ONU's ONU-ID,
    Alloc-IDs, OMCI Port-ID and delimiter from the exchange, and learns
    RESET_OFFSET by matching bursts to grants of the same length. Linux front
    end over /dev/mem, raw dump and replay; host test on a register model.
    [main.c, sniffer.c, sniffer.h, test_sniffer.c]
2026-11-05 Sniffer tool: decode upstream bursts by their matched grants
    Each burst's BWmap entries (PLOAMu, PLSu, DBRu flags; FEC parity removed)
    split it into PLOAMu (CRC checked), DBRu and GEM frames (HEC checked, idle
    skipped, OMCI header decoded on OMCI Port-IDs), so the stock ONU's OMCI
    answers appear in the log. Test bursts carry an Acknowledge, a report and
    an OMCI answer.
    [sniffer.c, sniffer.h, test_sniffer.c]
2026-11-05 Sniffer tool: UIO interrupt mode, device tree overlay
    ghrd_top.py writes pon_irqs.h (f2h_irq1 bit per PonBoard IRQ, the sniffer is
    bit 17); uio_overlay.sh builds sniffer-uio.dtbo (generic-uio on the lwOnu
    page, level IRQ) from it and the f2h_irq1 GIC SPI base, a required argument
    until checked on the board. sniffer -u waits on the interrupt instead of
    polling /dev/mem.
2026-11-05 Sniffer tool: OMCI profile output
    OMCI messages are reassembled per Port-ID in both directions; each ONU
    answer is paired with the OLT request of the same TCI and type and written
    (-P) as one line: request body, answer body, the request's name and ME.
    Exact repeats are skipped; a loader keeps the last answer of a request.
    [main.c, sniffer.c, sniffer.h, test_sniffer.c]
2026-11-05 OMCI profile loader: answer requests from a sniffed profile
    common/sw/omci: portable C that loads the sniffer's -P profile (later lines
    replace an earlier request's answer) and builds the recorded answer to a
    request with its TCI and a fresh trailer (baseline: AAL5 CRC-32 over bytes
    0-43; extended: the same CRC, unverified). The sniffer shares its OMCI body
    parsing.
    [sniffer.c]
2026-11-05 ONU Linux driver on the GPL GPON core, binary OMCI profile
    common/sw/linux (GPL-2.0-or-later): the HPS platform driver of our ONU, built
    out of tree with the OpenWrt fork's gpon core. Activation stays in the FPGA;
    OMCI fragments from the CPU GEM queues are reassembled on the OMCI Port-ID,
    answered by the core's responder (owed AVCs and the VEIP up AVC after it),
    CPU PLOAMs counted per type, sticky errors logged, a clone profile loaded by
    request_firmware. Compile-checked against a 6.18 x86 tree.
    common/sw/omci: omci_profile turns a sniffer -P profile into the binary one
    (OMCIPRF1, sorted 76-byte records) the core's omci_onu_set_profile searches.
    OnuRegs: the shadow key registers are named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
2026-11-05 VCXO ordering codes: 3225 has no OE option, wider pull on the HSMC card
    SiT3821 code field 'E' (output enable) exists only in the 7050/5032
    packages; the 3.2 x 2.5 mm part is 'N'. On the HSMC card the +-50 ppm pull
    (absolute +-20 ppm with +-25 ppm stability, ~30 % of it lost to the 20k /
    100k VIN divider) could not follow an 802.3 +-100 ppm EPON OLT: 156.25 MHz
    gets +-200 ppm (APR +-170), 155.52 MHz +-100 ppm (APR +-70). Footprint and
    pinout unchanged; DRC, parity and ERC clean.
    [hsmc.kicad_pcb, hsmc.kicad_sch, onu.kicad_pcb, onu.kicad_sch, sniffer.kicad_pcb, sniffer.kicad_sch]
2026-11-05 HSMC card: refclk series resistors, JLCPCB order package
    - R58-R61: 20 ohm in series on the four refclk legs into the GTS 100 ohm
    termination (LVPECL 1.2-2.0 Vpp -> 0.86-1.43 Vpp, inside the GTS
    0.6-1.7 Vpp input range and 0.85 V abs max). ECO on the routed board:
    REFCLK legs 18.6/14.8 mm, RXREF rerouted 30.2/26.2 mm, skew 3.9 mm each;
    DRC 0 errors, 0 unconnected, parity and ERC clean.
    - fab.py <board> [--stock]: DRC + parity gate, gerbers, drill, JLC BOM
    (one line per LCSC code) and CPL, README with consigned / hand-soldered
    parts and the board's order-notes.md; parts mapped in <board>/lcsc.csv.
    [hsmc.kicad_pcb, hsmc.kicad_sch, lcsc.csv]
2026-11-05 HSMC card: discrete burst laser driver simulation (SY88236 replacement WIP)
    ngspice netlist of the planned driver: BFR380F current-steering pairs on a
    5 V laser rail, data pair on the ONU TX lane, BEN steering bias and
    modulation, op-amp regulated tails; eye.py reports the eye at mid-UI.
    Bias 30 + mod 30 mA: on 2.4 ns, off ~2 ns, eye ~75 % with a 22 ohm +
    22 pF snubber across the laser.
2026-11-07 FPGA usage pictures, rewritten by every fit
    usage_svg.py reads the Quartus fit report and writes, per image (PonBoard
    alone, ghrd with the HPS): every resource used and free, ALMs and M20K per
    block (ONU/OLT MAC, ONU/OLT acceleration, Ethernet, sniffer, platform,
    free), and the ONU and OLT cores' sub-blocks with the flow engine split
    from the L2 bridge. fit.sh runs it after each successful PonBoard or ghrd
    fit, so the pictures follow the design. Light and dark mode, tooltips.
2026-11-07 Acceleration plan from the RTL9602C, luna and Cortina engines
    Architecture-level comparison of the three shipping ONU flow engines with
    ours, and the additions in order: per-layer bypass, trap table, debug
    snapshot, flow counters and age, egress interface table, ME 171 VLAN
    classifier, policers, queues, L2 learning, multicast, DRAM flow table.
2026-11-08 Bridge: per-layer bypass, trap actions per control protocol, lookup snapshot
    BYPASS turns each acceleration layer off for an engine bug: IPv4 / IPv6
    lookup, NAPT, PPPoE add/strip, VLAN rewrite (a flow needing one is a miss,
    so the CPU in flows mode; bridged VLAN rewrites to the CPU) and L2 (bridged
    frames to the CPU). FrameParser now gives a TrapReason (ARP, PPPoE
    discovery, PPP control, EAPOL, LLDP, slow, IGMP, DHCP, DHCPv6, ICMPv6,
    hop-by-hop); TRAP_LAN / TRAP_WAN pick per reason: as the rules say, CPU
    control queue, CPU data queue or drop; a trapped frame takes no flow.
    SNAP_ARM copies the next frame's parse, bucket, way, hit and decision into
    SNAP_* for bring-up. Defaults keep the previo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
2026-11-08 Bridge: T-CONT queue room from the registered FIFO availability (311.04 MHz)
    The GHRD image at 94 % ALMs failed setup by 0.070 ns on the ONU mover's
    room check (FIFO availability adders, compare, queue mux in one clock).
    The availability is now registered; a clock old it is at most the
    previous frame's last byte too high, so the check is strict.
    GHRD fit: 43783 ALMs (94 %), 312 M20K, setup slack +0.025 ns.
2026-11-08 Bridge: flow counters, a pool of 63 per direction
    A flow's action names a counter (FLOW_NAT bits 30-25, 0 none); each frame
    that takes the flow adds one packet and its IP bytes (40 bits).
    FLOW_COUNT_QUERY reads a counter and clears it (FLOW_PACKETS, FLOW_BYTES,
    FLOW_COUNT). One read-add-write or read-clear in flight at a time, MLAB.
    A pool as in luna and Cortina: a counter per flow would cost ~40 M20K.
    Age stays the hit bit: set by hardware, swept by FLOW_HIT_QUERY.
    GHRD fit: 44174 ALMs (94 %), 312 M20K, setup +0.075 ns; PonBoard 42307
    ALMs, +0.066 ns.
2026-11-13 In-line GPON sniffer: RTL, host link and board generator
    RTL (pon.sniffer): InlineSniffer, InlineDump, WideDs, UsRegen, UsReplay,
    Ft245; FilterRegs shared with the passive tap; the ECP5 DCU moved to
    common/hw/ecp5 for both cards.
    Host: sniffer -i PORT (inline.c) on the FT2232H tty, decoder shared.
    PCB generator: inline() netlist and inline_layout() placement for
    ../FPGA-USB-GPON-sniffer, laser() (MAX3643), cutoff() factored out of the
    HSMC card, 45F symbol, VCXO 7x5, OLT BOSA and shield clip lands. The four
    older boards generate the same netlist.
2026-11-13 In-line board: BOSA pad rows for any lead order, SiT3372 land, its own SerDes net patterns
2026-11-13 In-line sniffer: Artix-7 board, upstream bit tracking, laser safety bits
    RTL: UsClean (4x samples, tracks the ONU's bit phase, constant delay),
    InlineSniffer(benDelay, zeros) for the GTP lanes: zeros right after a
    burst, LASERS.apd (APD bias enable), STATUS.burstCut, I2C scl2 for the
    second DAC.
    PCB generator: Bridge.artix7 (XC7A35T-FGG484, its supplies and GTP LDOs),
    inline() on the Artix with a fixed 155.52 MHz XO, 2 x MCP4728 + ADS7828
    in place of the AD5593R, APD bias enable, DC-coupled upstream receiver;
    BGA fanout and core plane from the placed footprint (any package and
    rotation), inline_layout() for the FGG484. Buck inductor
    SLO252012F2R2MTT (in the JLCPCB library) on every board.
    C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
    [olt.kicad_sch, onu.kicad_sch, sniffer.kicad_sch]
2026-11-13 In-line sniffer: USB 2.0 HS through a USB3320 ULPI PHY and LUNA instead of the FT2232H
    The dump's link becomes byte streams in the PHY's 60 MHz domain (dual-clock
    queues both ways, a short packet at each record end); Ft245 removed. Board:
    USB3320 with its reference from the FPGA, no FT2232HL / EEPROM / crystal.
    Host tool: /dev/ttyACM0 (CDC-ACM).
    [boards.py, inline.c, inline.h, main.c, mksym.py]
2026-11-13 PCB generator: BOSA land measured on ONU scans, in-line board cells, fr-engine routing
    - bosa.py: one BOSA footprint (bridge:BOSA_GPON) from the land measured on 1200 dpi scans of stripped
    ONU boards; lead functions provisional, a Verify field makes fab.py refuse the board until measured.
    - place.py: laser_cell, tia_pair and pecl_outputs lay the optical cells of the in-line board, parts and
    tracks; USB3320 turned to the FPGA; 84 x 54 mm.
    - boards.py / pcbgen.py: power_nets puts VBUS in the Power class.
    - route.py: engine step and fr-engine strategy, STRATEGIES selects; finish.py gets the board's own
    folder, so a routed copy keeps 3D model paths relative to the project.
    - mk3d.py: 3D mo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
2026-11-13 BOSA lead functions from published TO-can drawings and the X100DG copper
    RX can: B is ground (the middle of the three close leads, on the plane on both sides of the scanned
    board), A / C the TIA pair, D VCC, E APD bias; the former table had ground on C and the pair on A / B
    (a torn pad read as a plane connection). TX can: T4 case on GND, T1 laser anode + monitor cathode,
    T2 monitor anode, T3 laser cathode. The measurement gate is gone: a BOSA is bought against the table.
    tia_pair: each leg enters its lead from the north, the ground lead stands between the two.
2026-11-13 In-line sniffer host tool: optical level setting (-L FILE)
    levels.c drives the box's two MCP4728 DACs and its ADS7828 ADC through the
    I2C register: APD biases, then each laser at what the other port receives +
    gain_db (floor, laser maximum), modulation from the slope and the extinction
    ratio, bias trimmed by the monitor diode; the burst level is found by moving
    the comparator's reference on US_LEVEL's counts. The unit's constants come
    from its level file. test_levels.c: models of the DACs, the ADC and both ports.
2026-11-13 In-line sniffer: receiver polarity register (RX.ds, RX.us)
    No BOSA datasheet says which lead of the TIA pair rises with light: each
    receiver's lane words can be inverted (register RX, 0x38), set by the host
    from the level file (olt_rx_inverted, onu_rx_inverted). InlineSnifferTest
    runs both receivers inverted; Artix-7 timing unchanged (+0.234 / +0.055 ns).
    [levels.c, levels.h, test_levels.c]
2026-11-14 PCB generator: receiver, lane and supply cells; decoupling at its own chip
    - tia_pair: the two terminations in line between the pair's legs, their middle the
    reference (upstream wholly on top, downstream across the N leg on the bottom);
    the burst receiver's offset resistors between the coupling capacitors.
    - lane_exit: the downstream receive pair leaves the ball field as a pair, its
    crossing laid at the balls.
    - pins_joined (USB3320 1.8 V pins), TPS61391 CAP capacitor at its pin, DONE
    pull-up off the core island.
    - passives: a decoupling capacitor goes to the chip it was declared after in its
    block, on BGA boards too (they sat around the BGA, up to 24 mm away).
    - plane_vias leaves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
